Nik-Sch/EDiC/thesis/eidesstatt.tex

% !TeX root = thesis.tex
\thispagestyle{empty}
\begin{LARGE}
	\ul{\textbf{Eidesstattliche Erkl\"arung}}
\end{LARGE}

\vspace{1cm}

Hiermit erkläre ich, dass ich die vorliegende Arbeit selbstständig und eigenhändig sowie ohne
unerlaubte fremde Hilfe und ausschlie\ss lich unter Verwendung der aufgeführten Quellen und Hilfsmittel
angefertigt habe.
\vspace{2cm}

Berlin, den \today

\vspace{1cm}

\rule{0.3\textwidth}{0.4pt}

Unterschrift

%\Datum
\vspace*{6cm}
\newpage
