Nik-Sch/EDiC/thesis/titlepage.tex

% !TeX root = ../thesis.tex
\begin{titlepage}
\begin{centering}
	% Header
	\begin{figure}[!h]
		\centering
		\begin{subfigure}{.45\textwidth}
			% \centering
			
		\end{subfigure}
		\begin{subfigure}{.45\textwidth}
			\centering
			
		\end{subfigure}
	\end{figure}

	% vertikaler Zwischenraum
	\vspace{10mm}

	% Titel der Arbeit
	\LARGE

	Master Thesis

	\textbf{\Title}\\[1cm]

	\large
	created by\\
	\Author\\
	Matrikel: 376314\\[1cm]

	% Betreuer
	\hspace*{-1.5cm}
	\begin{minipage}{\linewidth}
		\begin{tabbing}
    	First examiner:\qquad \= Prof. Dr.-Ing. Reinhold Orglmeister,\\
			\>{Chair of Electronics and Medical Signal Processing,}\\
			\>{Technische Universität Berlin}\\
			\\
    	Second examiner:\>Prof. Dr.-Ing. Clemens Gühmann,\\
			\>{Chair of Electronic Measurement and Diagnostic Technology,}\\
			\>{Technische Universität Berlin}\\
			\\
    	Supervisor:\>Dipl.-Ing. Henry Westphal,\\
			\>{Tigris Elektronik GmbH}
  	\end{tabbing}
  \end{minipage}

	% vertikaler Zwischenraum
	\vspace{20mm}

	\normalsize

	\Date\\
\end{centering}
\end{titlepage}
