Nik-Sch/EDiC/thesis/plots/magneticField1.pdf

0 | 20 | 40 | 60 | 80 | 100
x in mm

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
H in Am

−1

2 wires 20mm apart
2 wires 1mm apart
