Nik-Sch/EDiC/Inbetriebnahme/2022-03-06/2022-03-06_NK.pdf

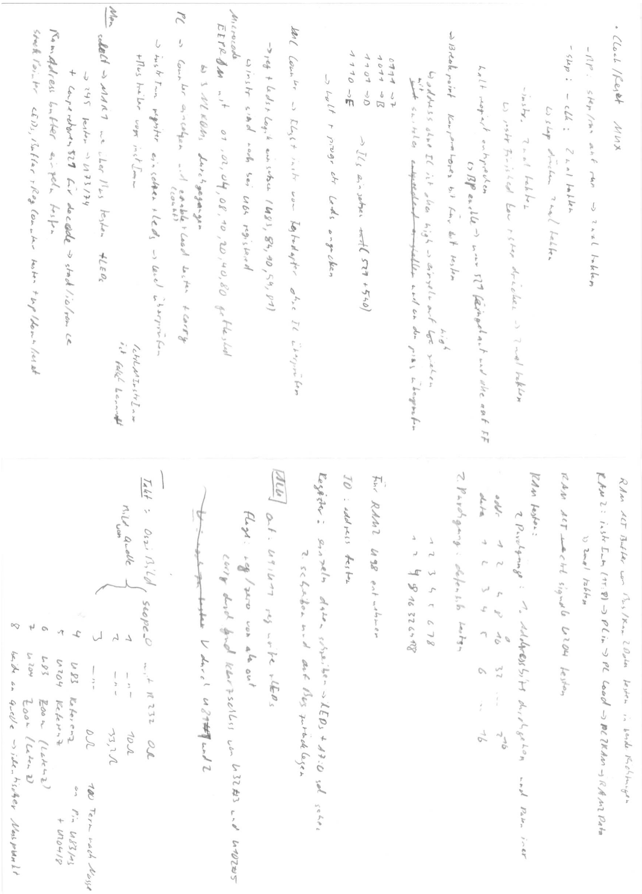
[picture p56: page 1]
