Nik-Sch/EDiC/doc/docHenry/fauch_0108202115232300.pdf

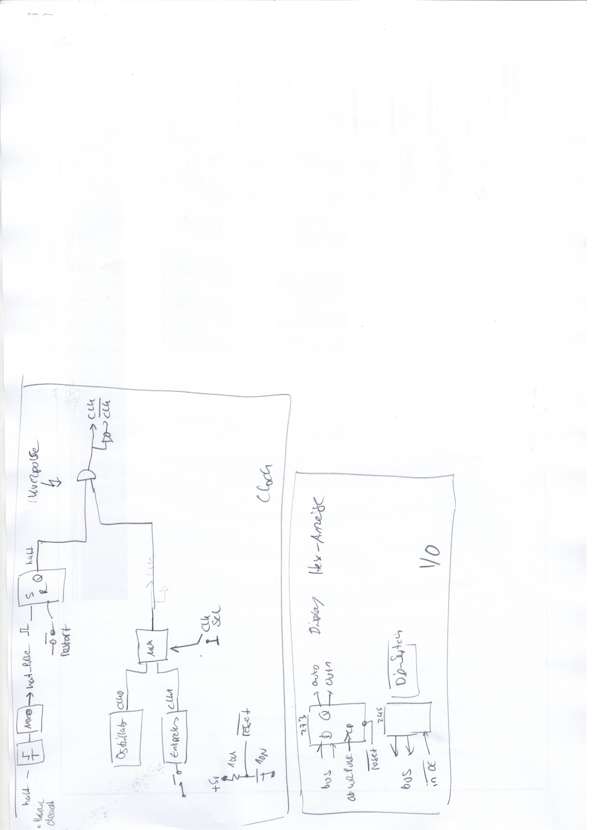
[picture p57: page 1]
