Nik-Sch/EDiC/doc/docHenry/fauch_0108202115245300.pdf

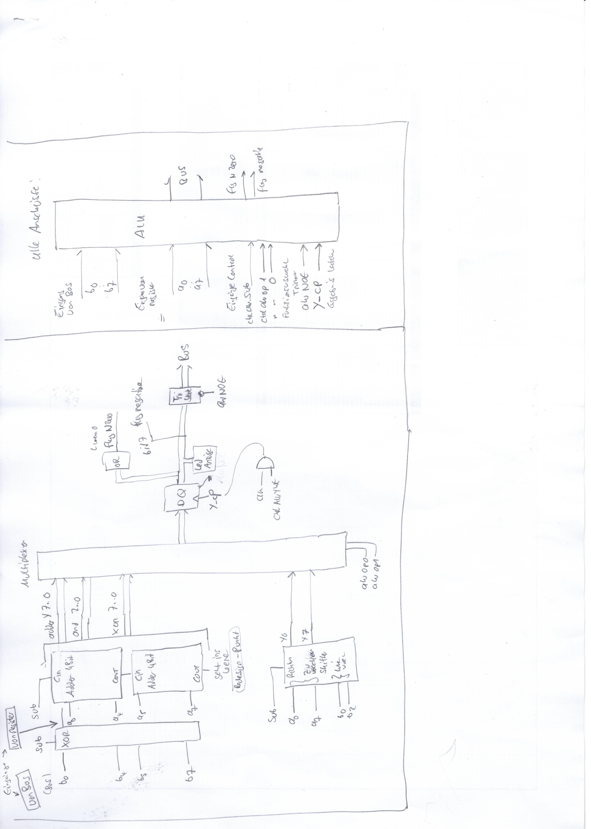
[picture p58: page 1]
