Nik-Sch/EDiC/doc/docHenry/fauch_0108202115251600.pdf

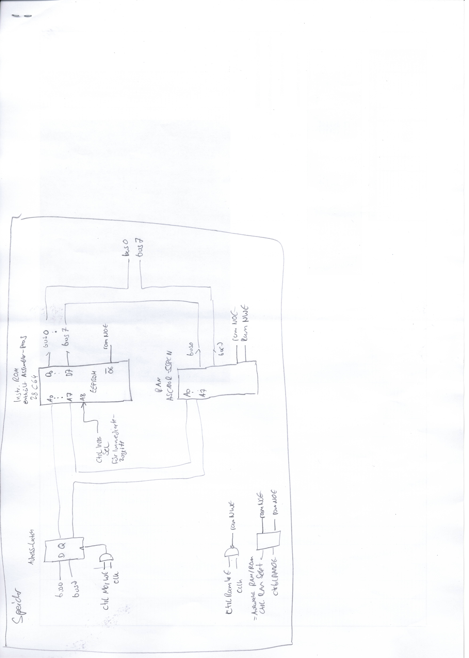
[picture p59: page 1]
