Nik-Sch/EDiC/doc/docHenry/fauch_0108202115253700.pdf

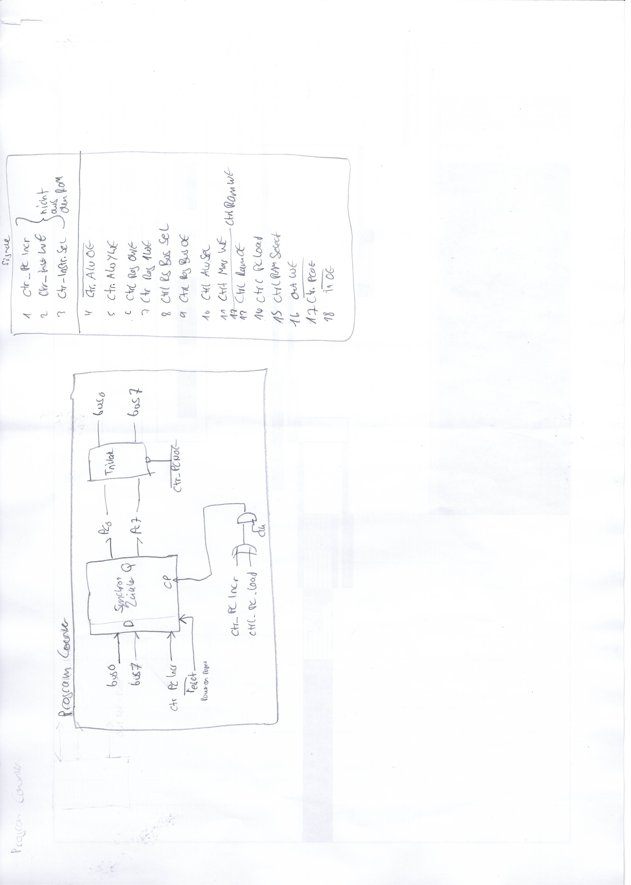
[picture p60: page 1]
