Nik-Sch/EDiC/doc/docHenry/fauch_0108202115255800.pdf

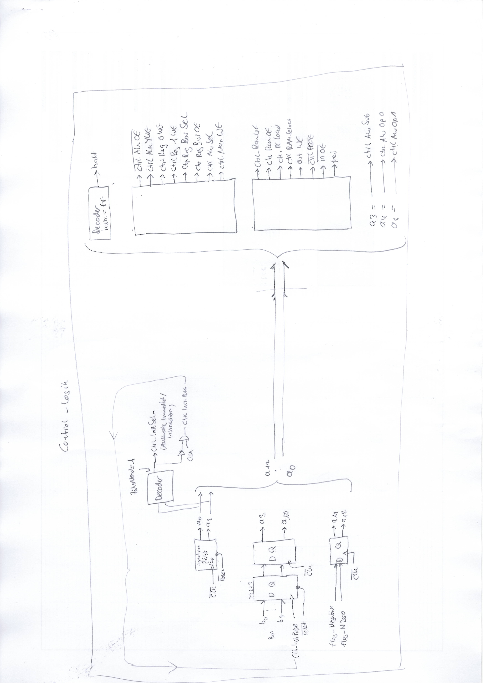
[picture p61: page 1]
