Nik-Sch/EDiC/doc/docHenry/fauch_0108202115262200.pdf

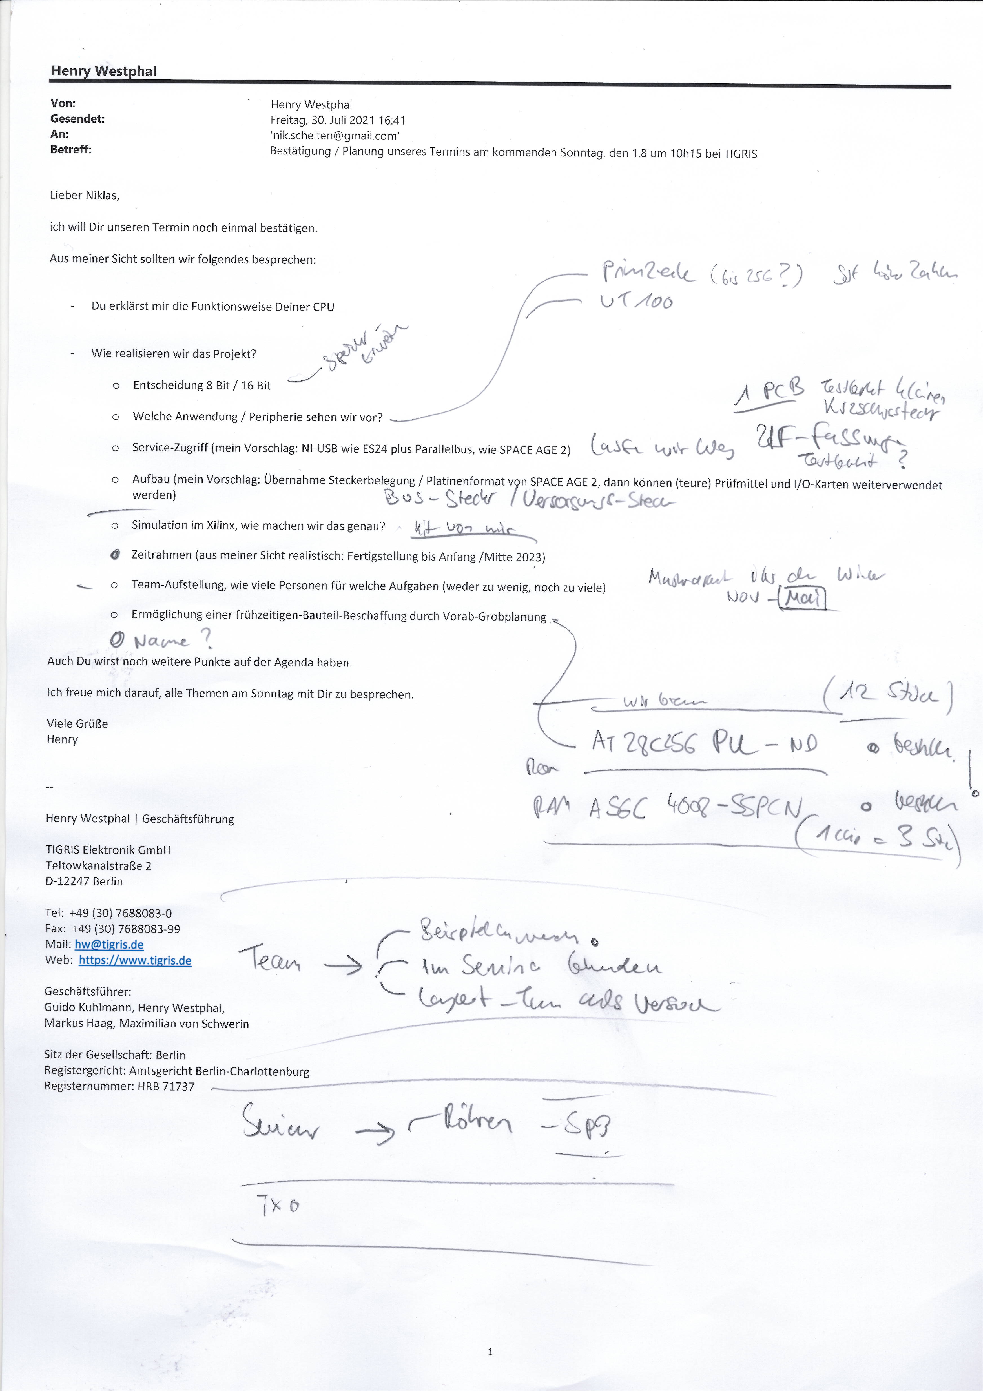
[picture p62: page 1]
