Nik-Sch/EDiC/doc/docHenry/fauch_0108202115264400.pdf

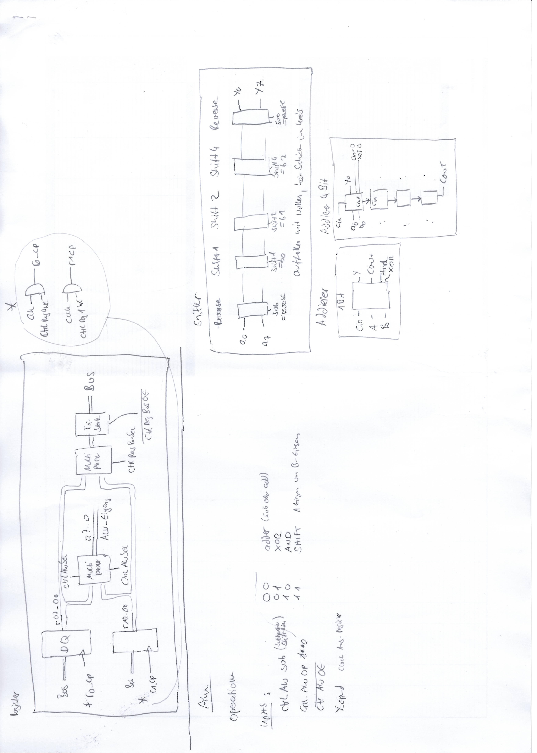
[picture p63: page 1]
