Nik-Sch/EDiC/doc/docHenry/fauch_0108202115271000.pdf

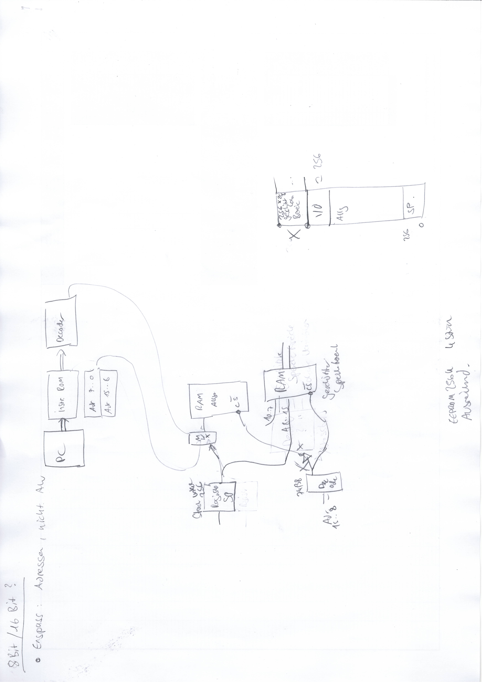
[picture p64: page 1]
