Nik-Sch/EDiC/Inbetriebnahme/2022-03-07/RigolDS0.png

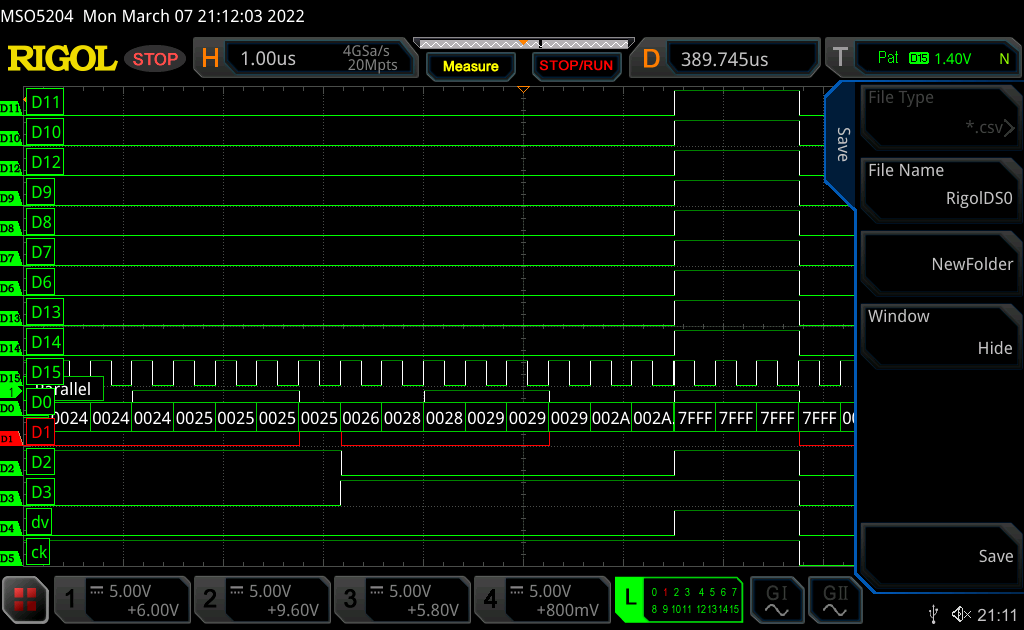
Inbetriebnahme/2022-03-07/RigolDS0.png
