Nik-Sch/EDiC/schematic/emsp_resized.png

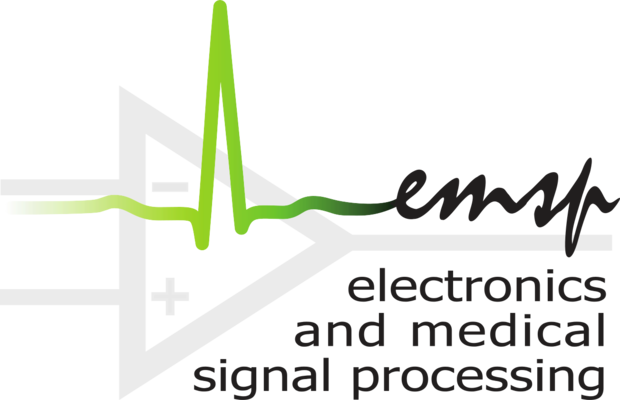
schematic/emsp_resized.png
