Nik-Sch/EDiC/schematic/tigris.png

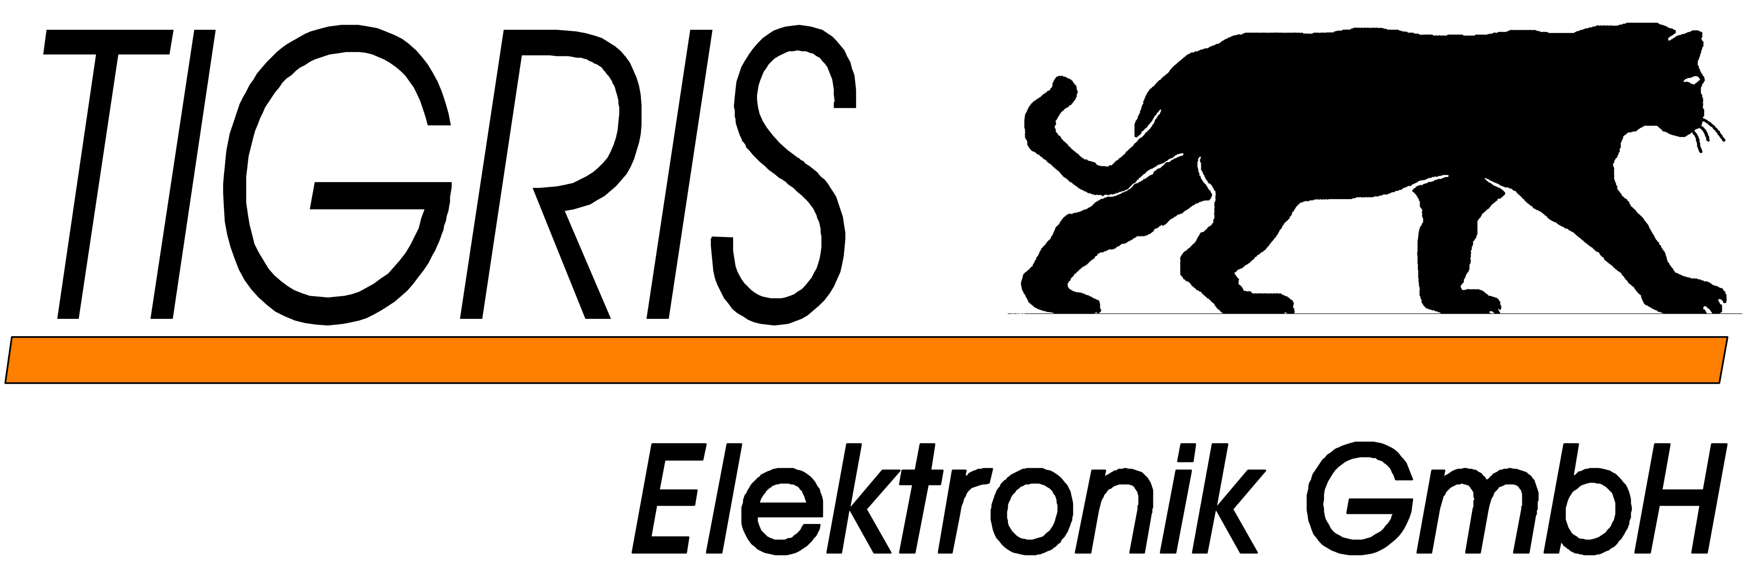
schematic/tigris.png
