Nik-Sch/EDiC/schematic/tu_resized.png

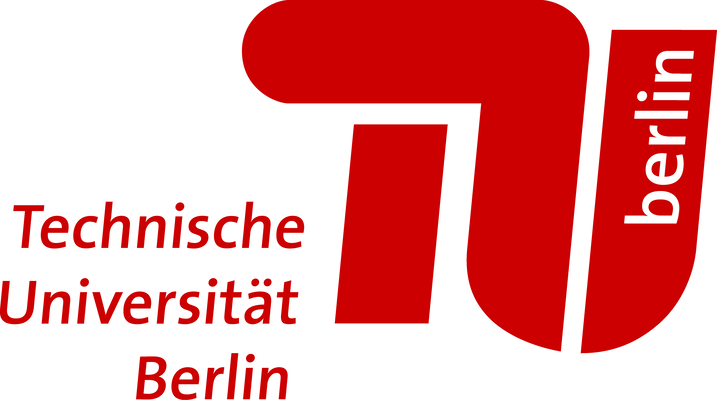
schematic/tu_resized.png
