Nik-Sch/EDiC/thesis/figures/scope_1.png

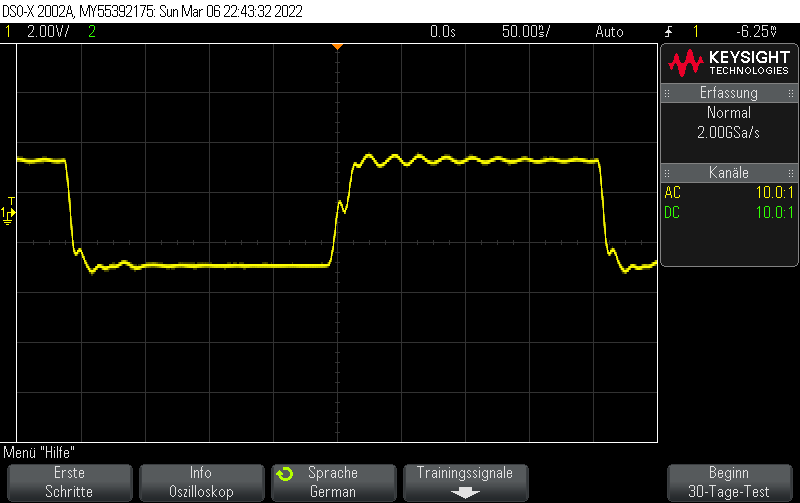
thesis/figures/scope_1.png
