Nik-Sch/EDiC/thesis/figures/scope_4.png

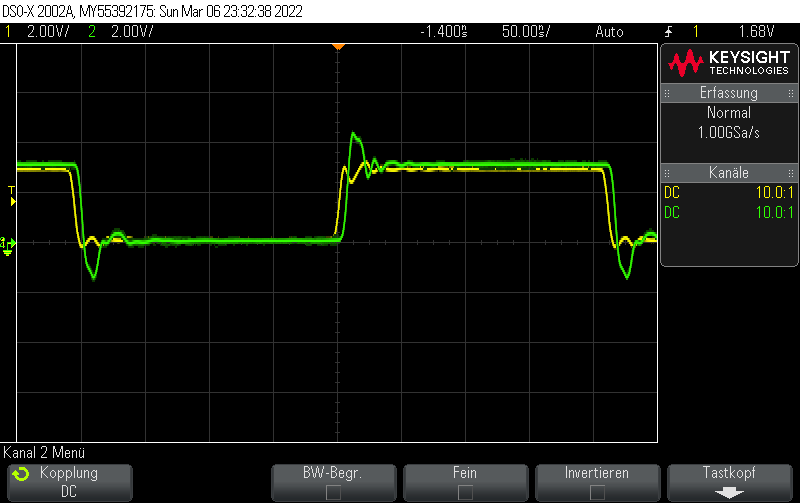
thesis/figures/scope_4.png
