Nik-Sch/EDiC/thesis/figures/scope_6.png

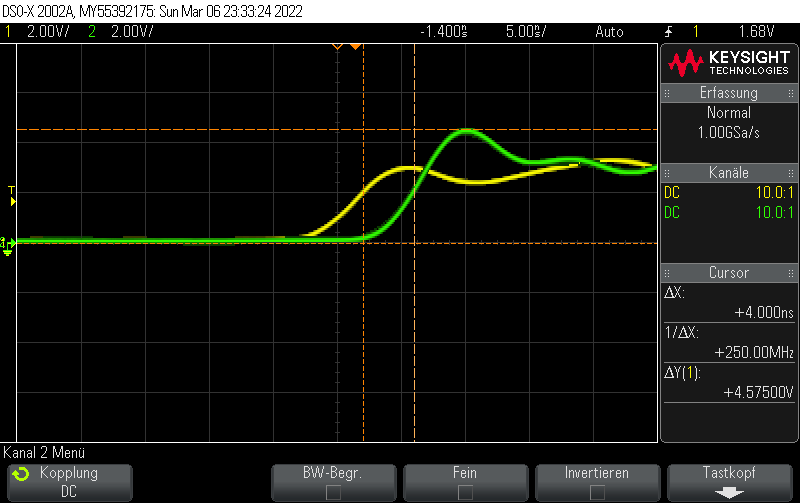
thesis/figures/scope_6.png
