Nik-Sch/EDiC/thesis/figures/scope_8.png

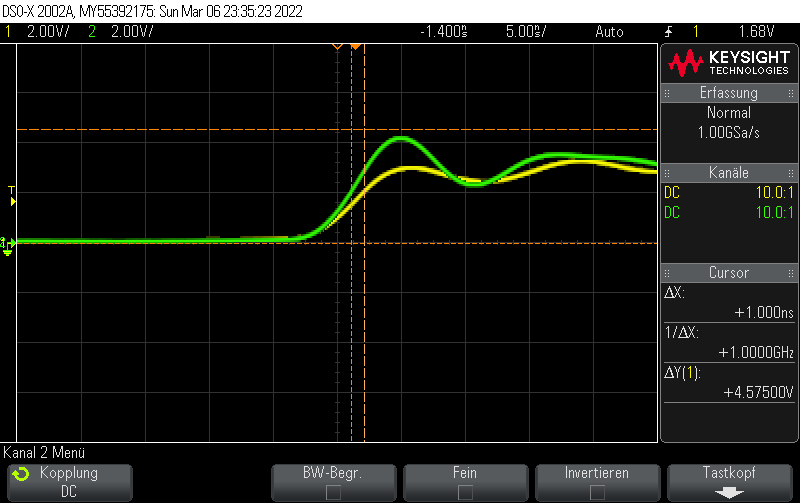
thesis/figures/scope_8.png
