Nik-Sch/EDiC/thesis/figures/scope_11.png

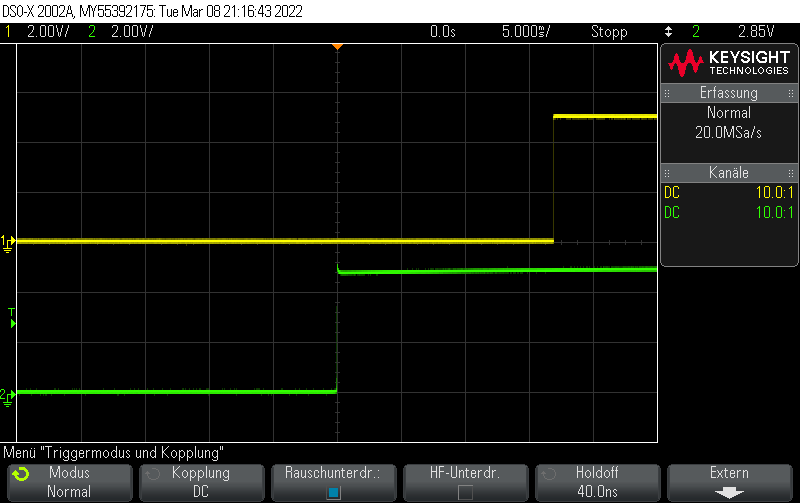
thesis/figures/scope_11.png
