Nik-Sch/EDiC/thesis/figures/scope_13.png

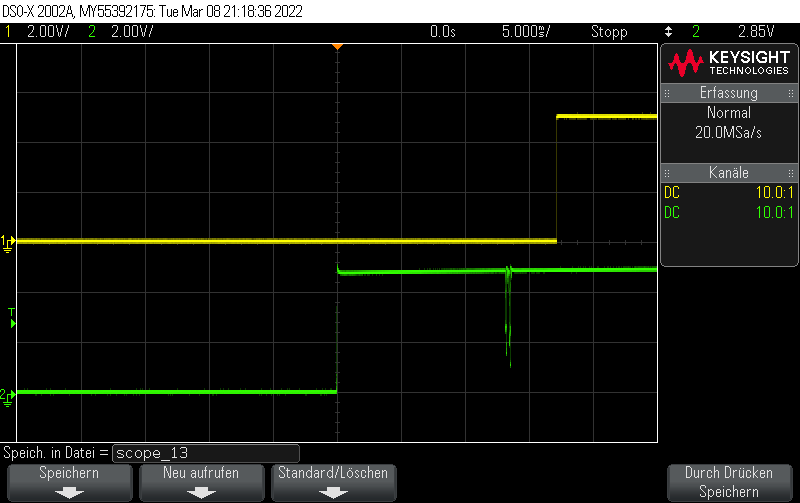
thesis/figures/scope_13.png
