Nik-Sch/EDiC/thesis/figures/scope_14.png

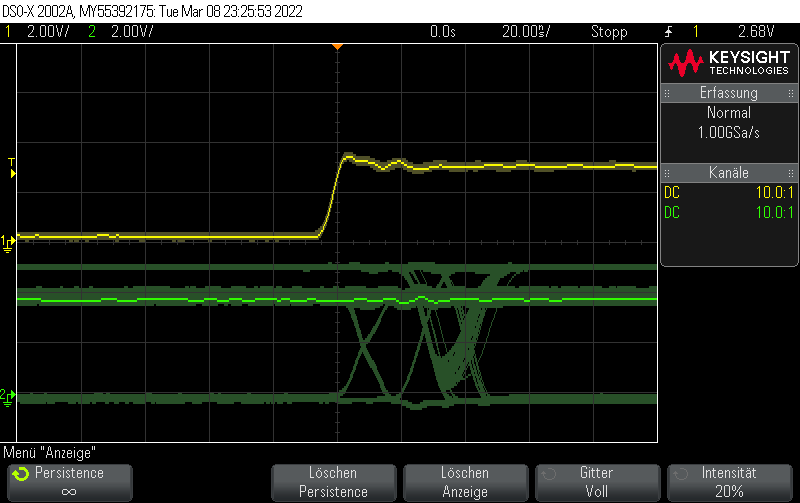
thesis/figures/scope_14.png
