Nik-Sch/EDiC/thesis/figures/scope_16.png

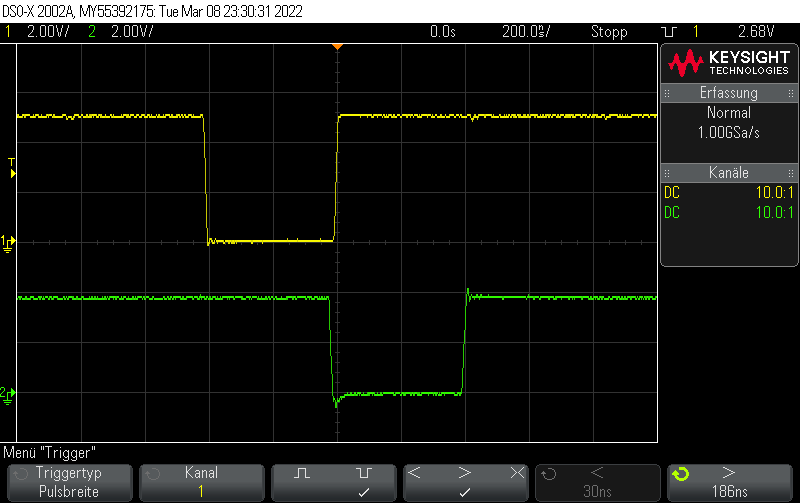
thesis/figures/scope_16.png
