Nik-Sch/EDiC/thesis/figures/update20210121_crop.jpg

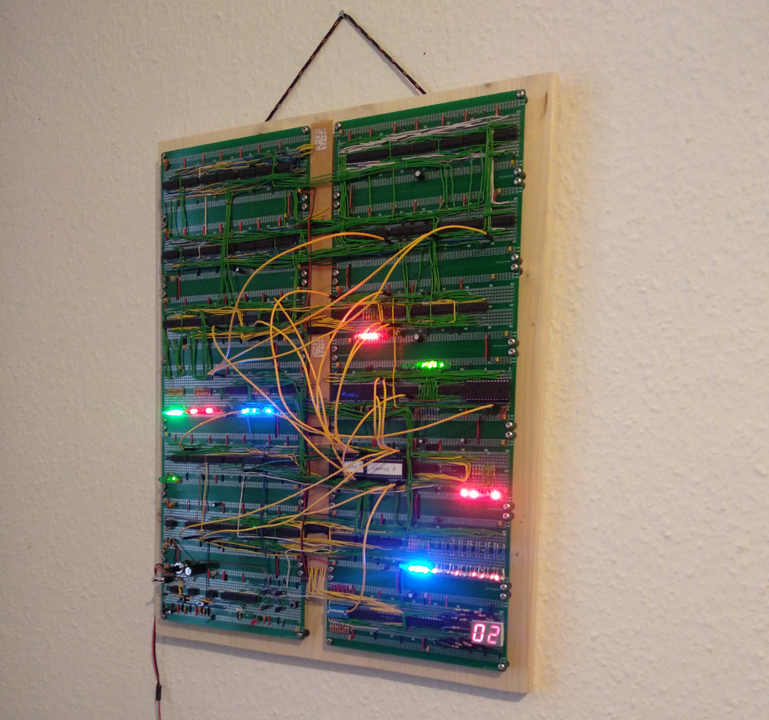
thesis/figures/update20210121_crop.jpg
