Nik-Sch/EDiC/thesis/appendix/c_assembler.tex

\chapter[Collection of assembler programs]{Collection of assembler programs for the \gls{EDiC}}
\begin{multipagecode}
  \caption{The full snake assembler program.}
  \begin{multicols}{2}
    \inputminted[linenos,
      breaklines,
      frame=leftline,
      xleftmargin=20pt,
    ]{ARM}{src/snake.s}
  \end{multicols}
  \label{lst:app_asm_snake}
\end{multipagecode}

\begin{multipagecode}
  \caption{The \gls{PRNG} assembler program ``prng.s'' used in the snake program in \cref{lst:app_asm_snake}.}
  \inputminted[linenos,
    breaklines,
    frame=leftline,
    xleftmargin=20pt,
  ]{ARM}{src/prng.s}
  \label{lst:app_asm_prng}
\end{multipagecode}

\begin{multipagecode}
  \caption{The utility library for the \gls{UART} extension card of the \gls{EDiC} with the \texttt{16c550} \gls{UART} Transceiver.}
  \begin{multicols}{2}
    \inputminted[linenos,
      breaklines,
      frame=leftline,
      xleftmargin=20pt,
    ]{ARM}{src/uart_16c550.s}
  \end{multicols}
  \label{lst:app_asm_uart}
\end{multipagecode}
