Nik-Sch/EDiC/thesis/figures/ledDriver.pdf

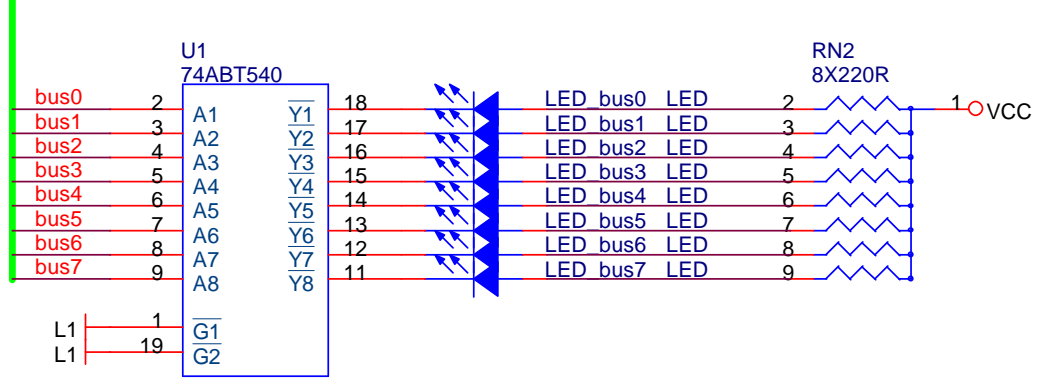
[picture p87: page 1]
bus3; bus6; bus1; bus7; bus0; bus4 bus5; bus2; VCC; LED_bus2 LED; LED_bus0 LED; LED_bus4 LED; U1 74ABT540; LED_bus5 LED; LED_bus7 LED; LED_bus6 LED; LED_bus3 LED; LED_bus1 LED
