Nik-Sch/EDiC/thesis/figures/schematic_5.pdf

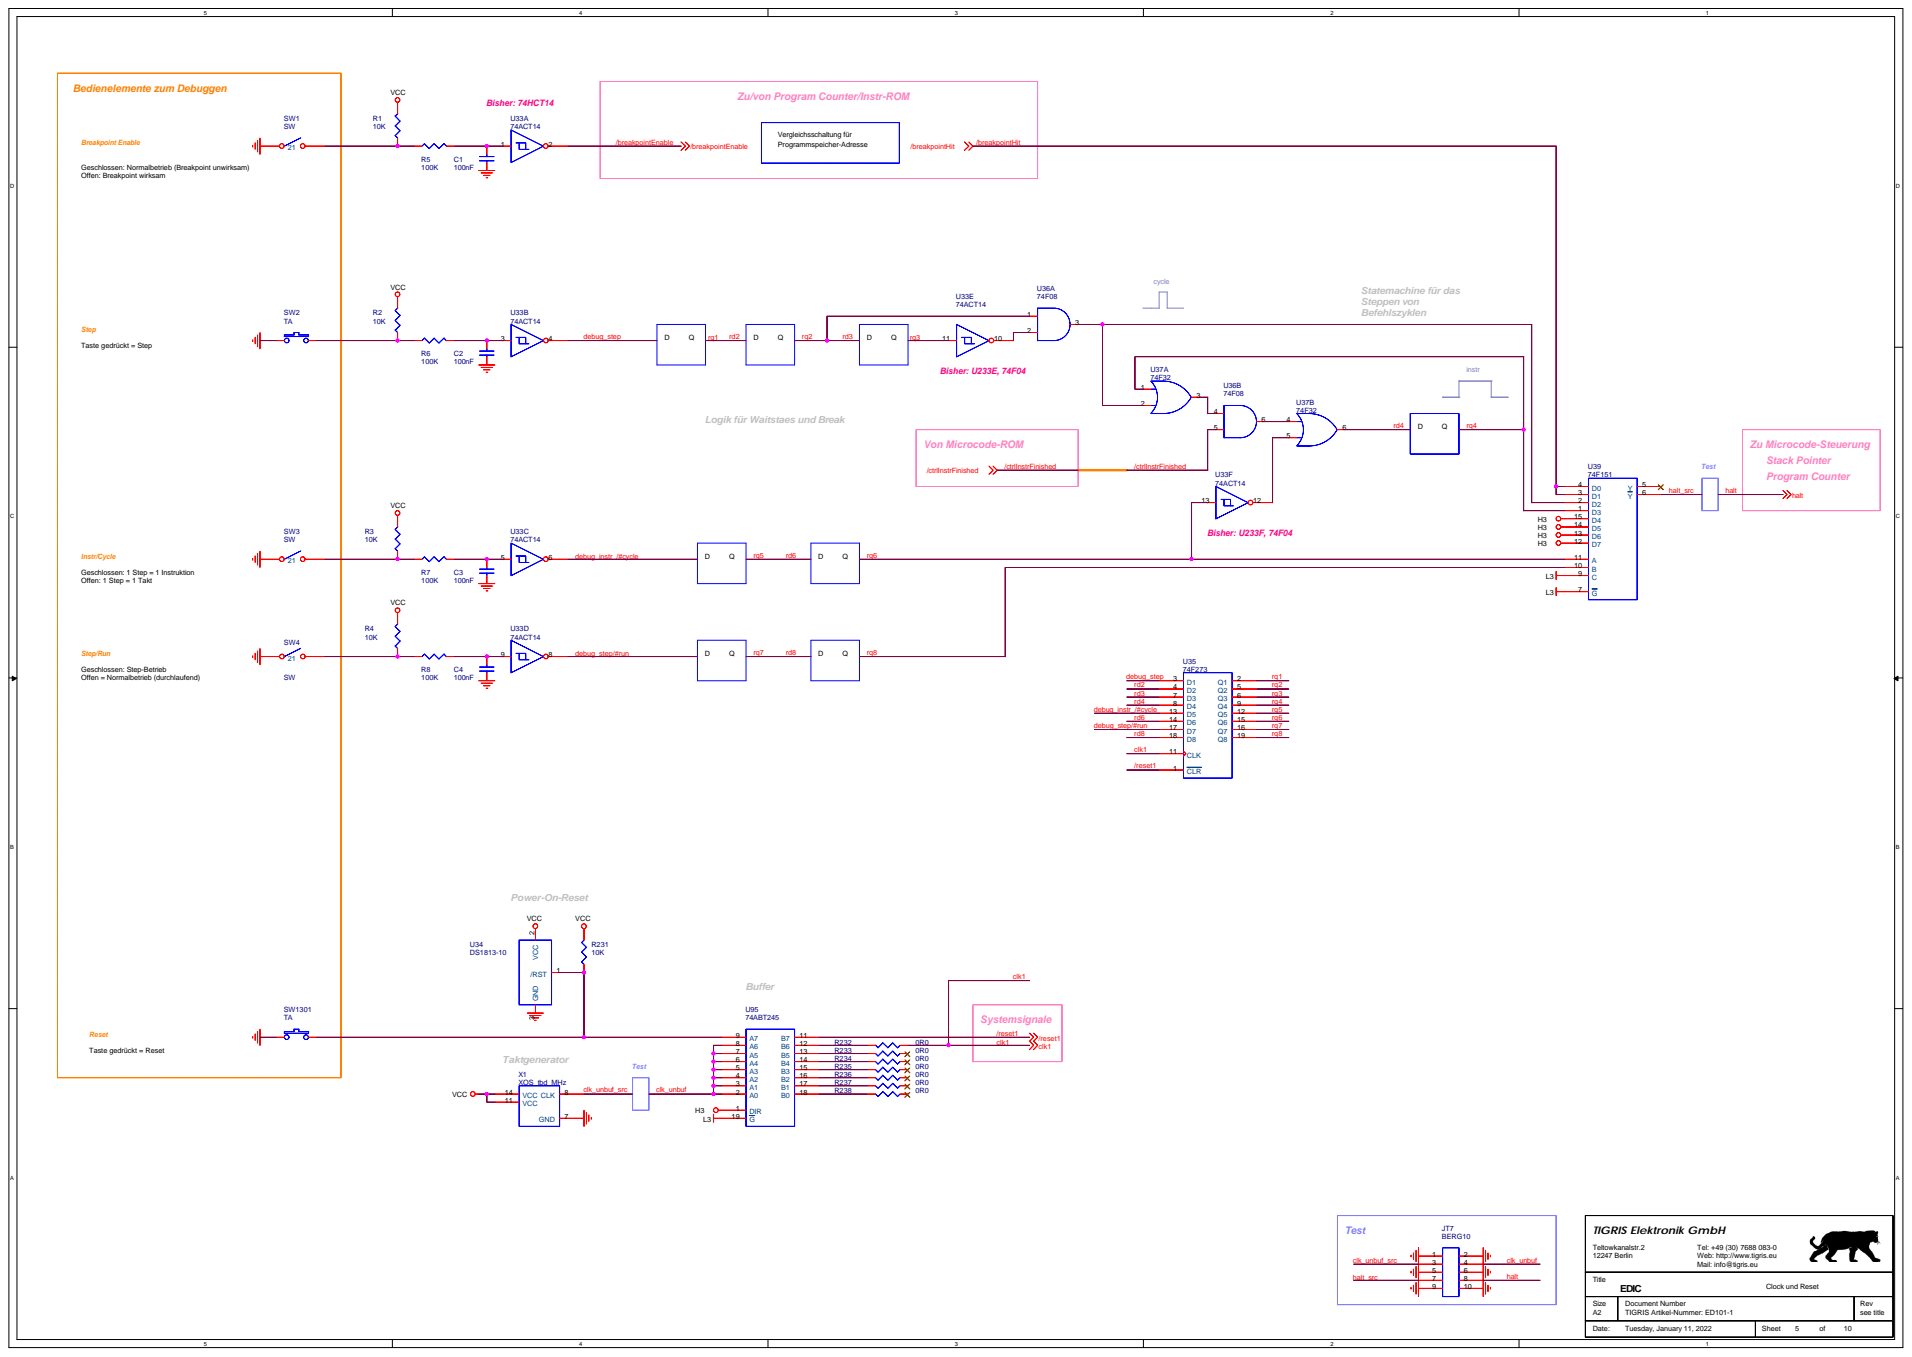
[picture p88: page 1]

Zu/von Program Counter/Instr-ROM

Geschlossen: Normalbetrieb (Breakpoint unwirksam)
Offen: Breakpoint wirksam

Logik für Waitstaes und Break

Tel: +49 (30) 7688 083-0
Web: http://www.tigris.eu
Mail: info@tigris.eu

Size A2 | Document Number TIGRIS Artikel-Nummer: ED101-1 | Rev see title

Date: Tuesday, January 11, 2022 | Sheet 5 of 10
