Nik-Sch/EDiC/schematic/CPU-Poster/EDiCPoster.pdf

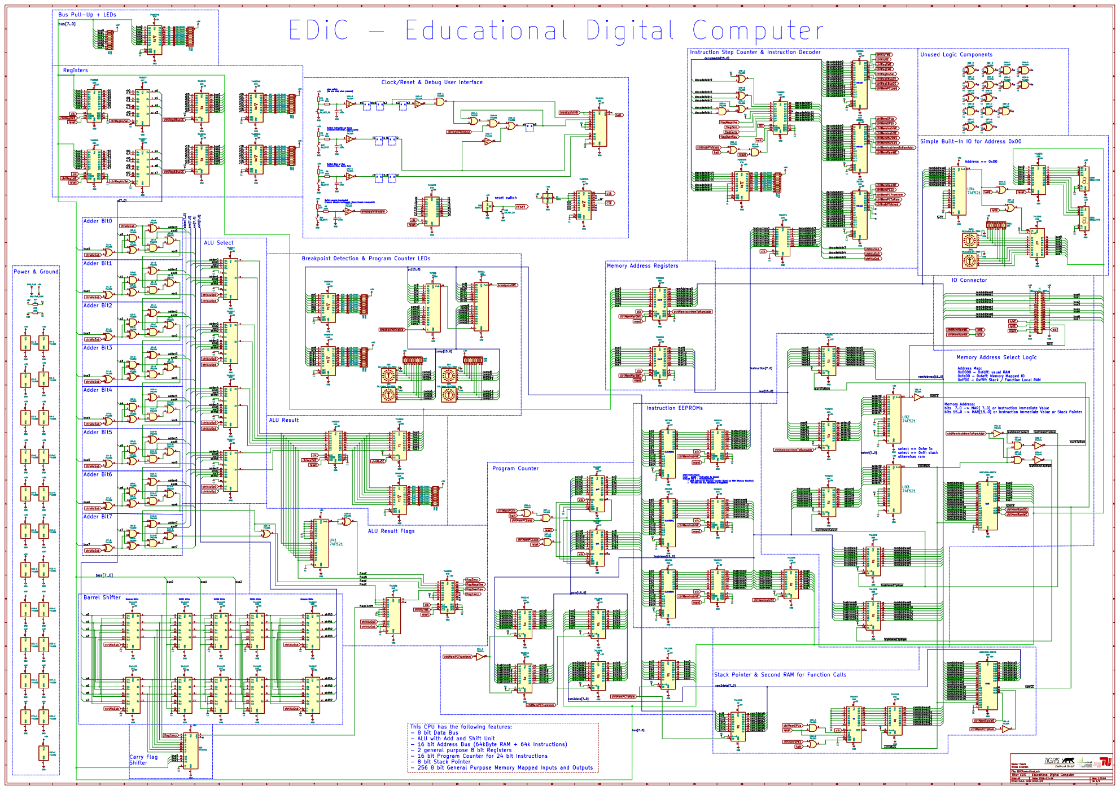
[picture p89: page 1]

Bus Pull-Up + LEDs

Instruction Step Counter & Instruction Decoder

Clock/Reset & Debug User Interface

micro0 Breakpoint Detection & Program Counter LEDs

step switch
(do one step when pressed)
74LS14 GND

Switch Instruction or Cycle
(Closed: Instruction, Open: Cycle)

Simple Built-In IO for Address 0x00

Switch Step or Run
(Closed: Step, Open: Run)

Switch enable breakpoint
(Closed: Disable breakpoint, Open: Enable breakpoint)

Memory Address Select Logic

0xff00 - 0xffff: Stack / Function Local RAM

Memory Address:
bits 7..0 -> MAR[ 7..0] or Instruction Immediate Value
bits 15..0 -> MAR[15..0] or Instruction Immediate Value or Stack Pointer

rom1&0 15: 0 - immediateValue:
- 15:0 address for Program Counter (jump) or RAM (Memory Oeration)
- 7:0 data for ALU Operation or Registers

This CPU has the following features:
- 8 bit Data Bus
- ALU with Add and Shift Unit
- 16 bit Address Bus (64kByte RAM + 64k Instructions)
- 2 general purpose 8 bit Registers
- 16 bit Program Counter for 24 bit Instructions
- 8 bit Stack Pointer
- 256 8 bit General Purpose Memory Mapped Inputs and Outputs

File: EDiCPoster.kicad_sch Niklas Schelten Master Thesis

Id: 1/1 Title: EDiC - Educational Digital Computer
