Nik-Sch/EDiC/thesis/figures/schemTA.pdf

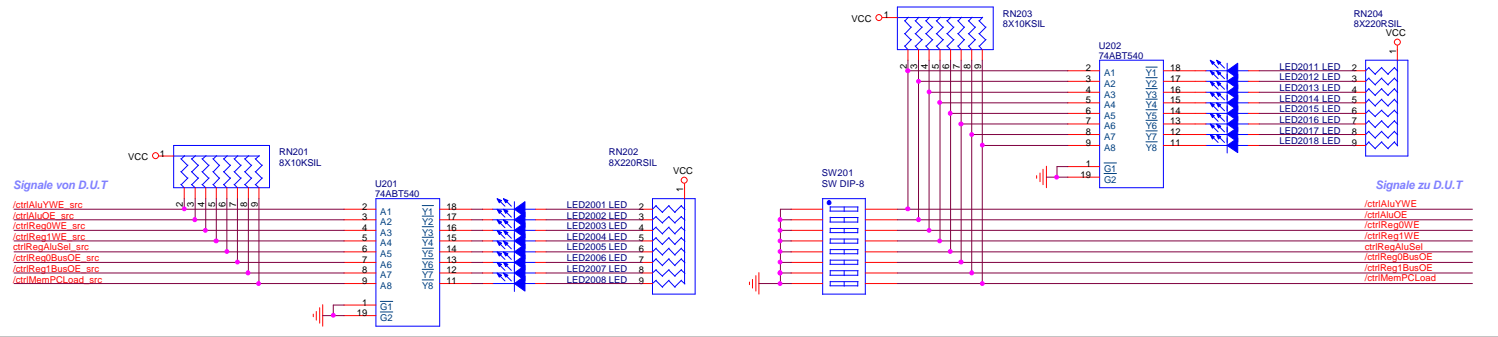
[picture p90: page 1]
