Nik-Sch/EDiC/thesis/figures/schemBasicIO.pdf

## Von Schaltungsteil RAM

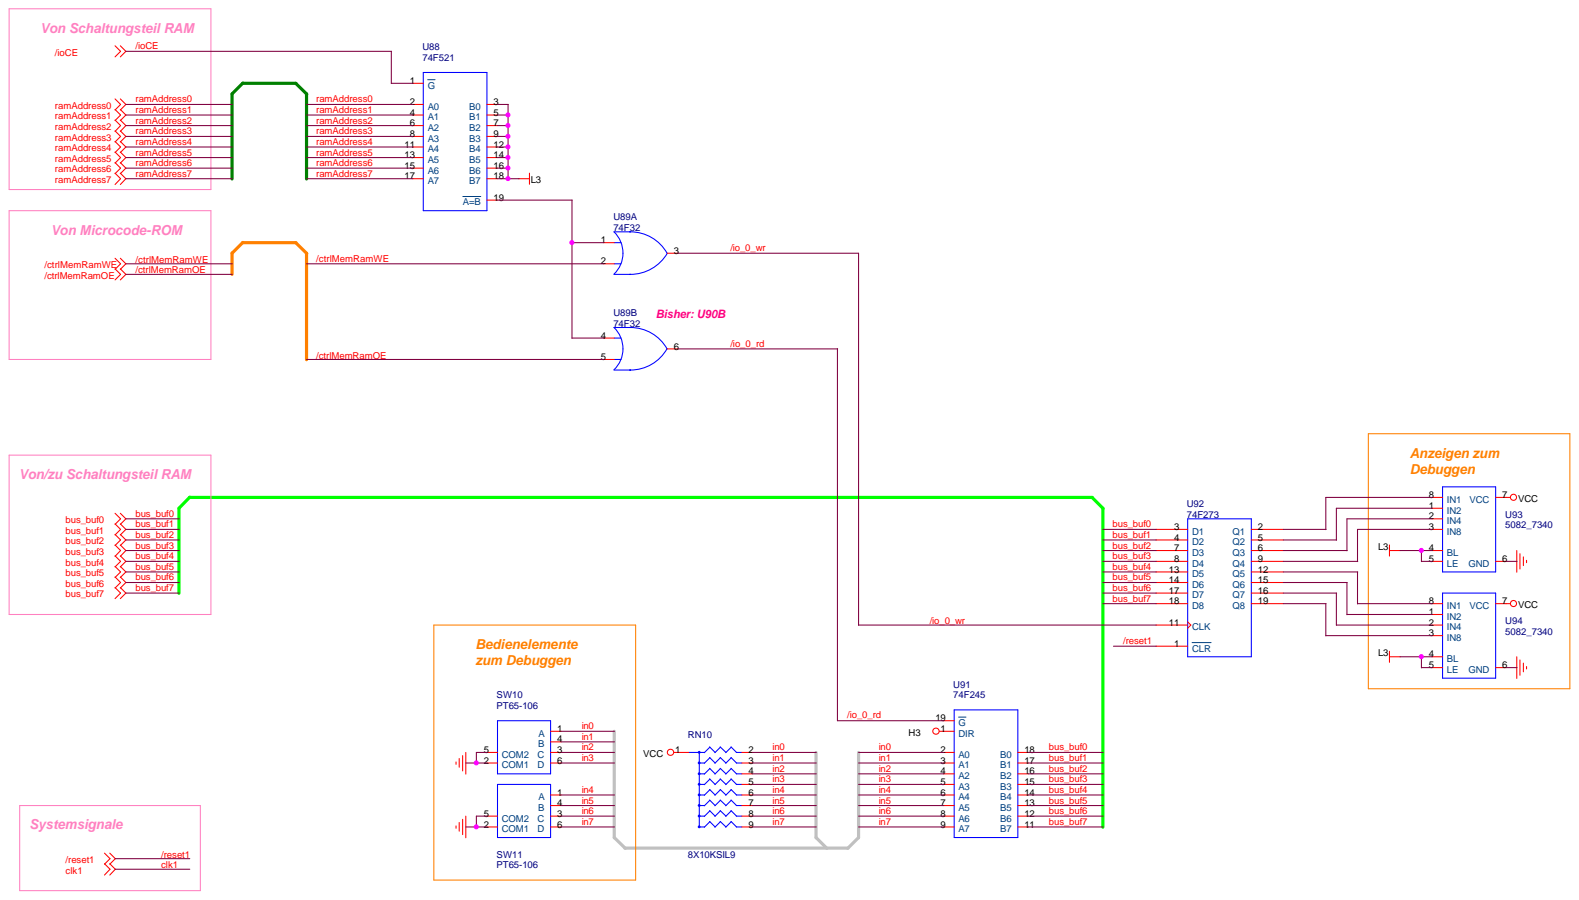
[picture p91: page 1]

ramAddress1 4 | 5
ramAddress2 6 | 7
ramAddress3 8 | 9
ramAddress4 11 | 12
ramAddress5 13 | 14
ramAddress6 15 | 16
ramAddress7 17 | 18

Von/zu Schaltungsteil RAM

1 | IN1 VCC U92

bus_buf1 4 | 5
bus_buf2 7 | 6
bus_buf3 8 | 9
bus_buf4 13 | 12
bus_buf5 14 | 15
bus_buf6 17 | 16

in2 4 | bus_buf2 16
in3 5 | 15 bus_buf3
