Nik-Sch/EDiC/thesis/figures/schemPC.pdf

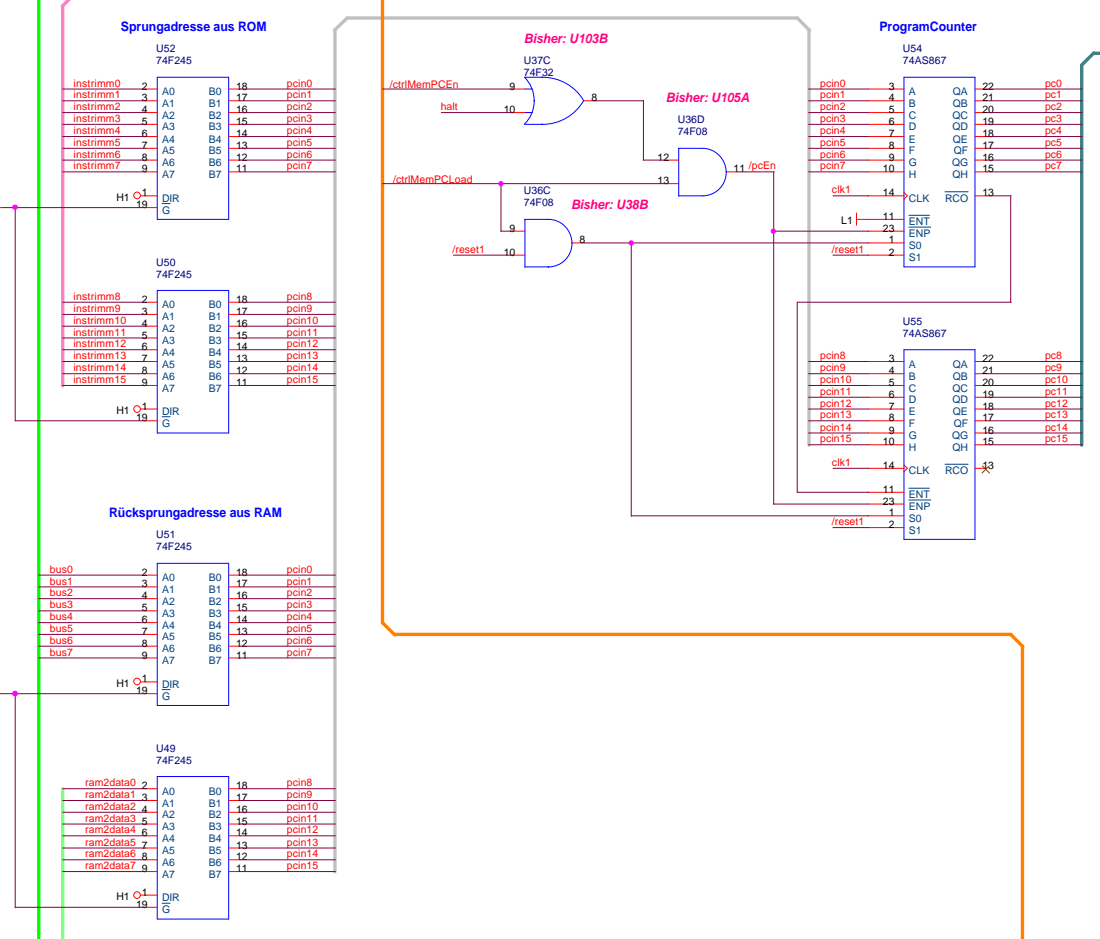
[picture p92: page 1]
