Nik-Sch/EDiC/thesis/figures/7400_Circuit.pdf

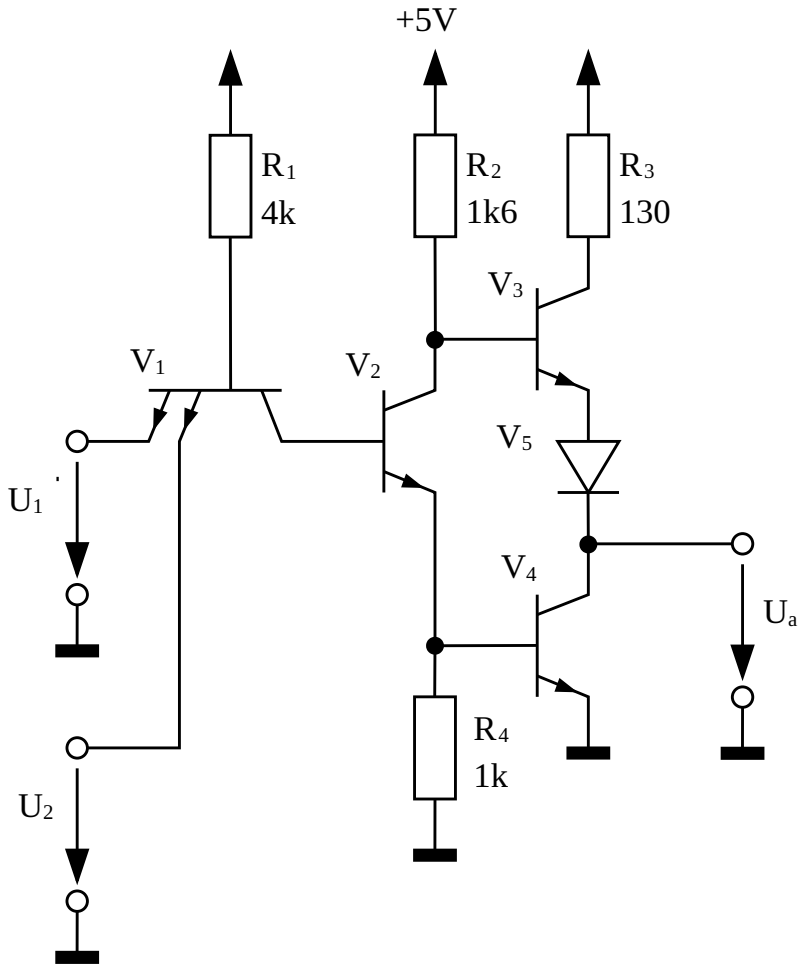
[picture p93: page 1]
