Nik-Sch/EDiC/thesis/figures/schematic_2.pdf

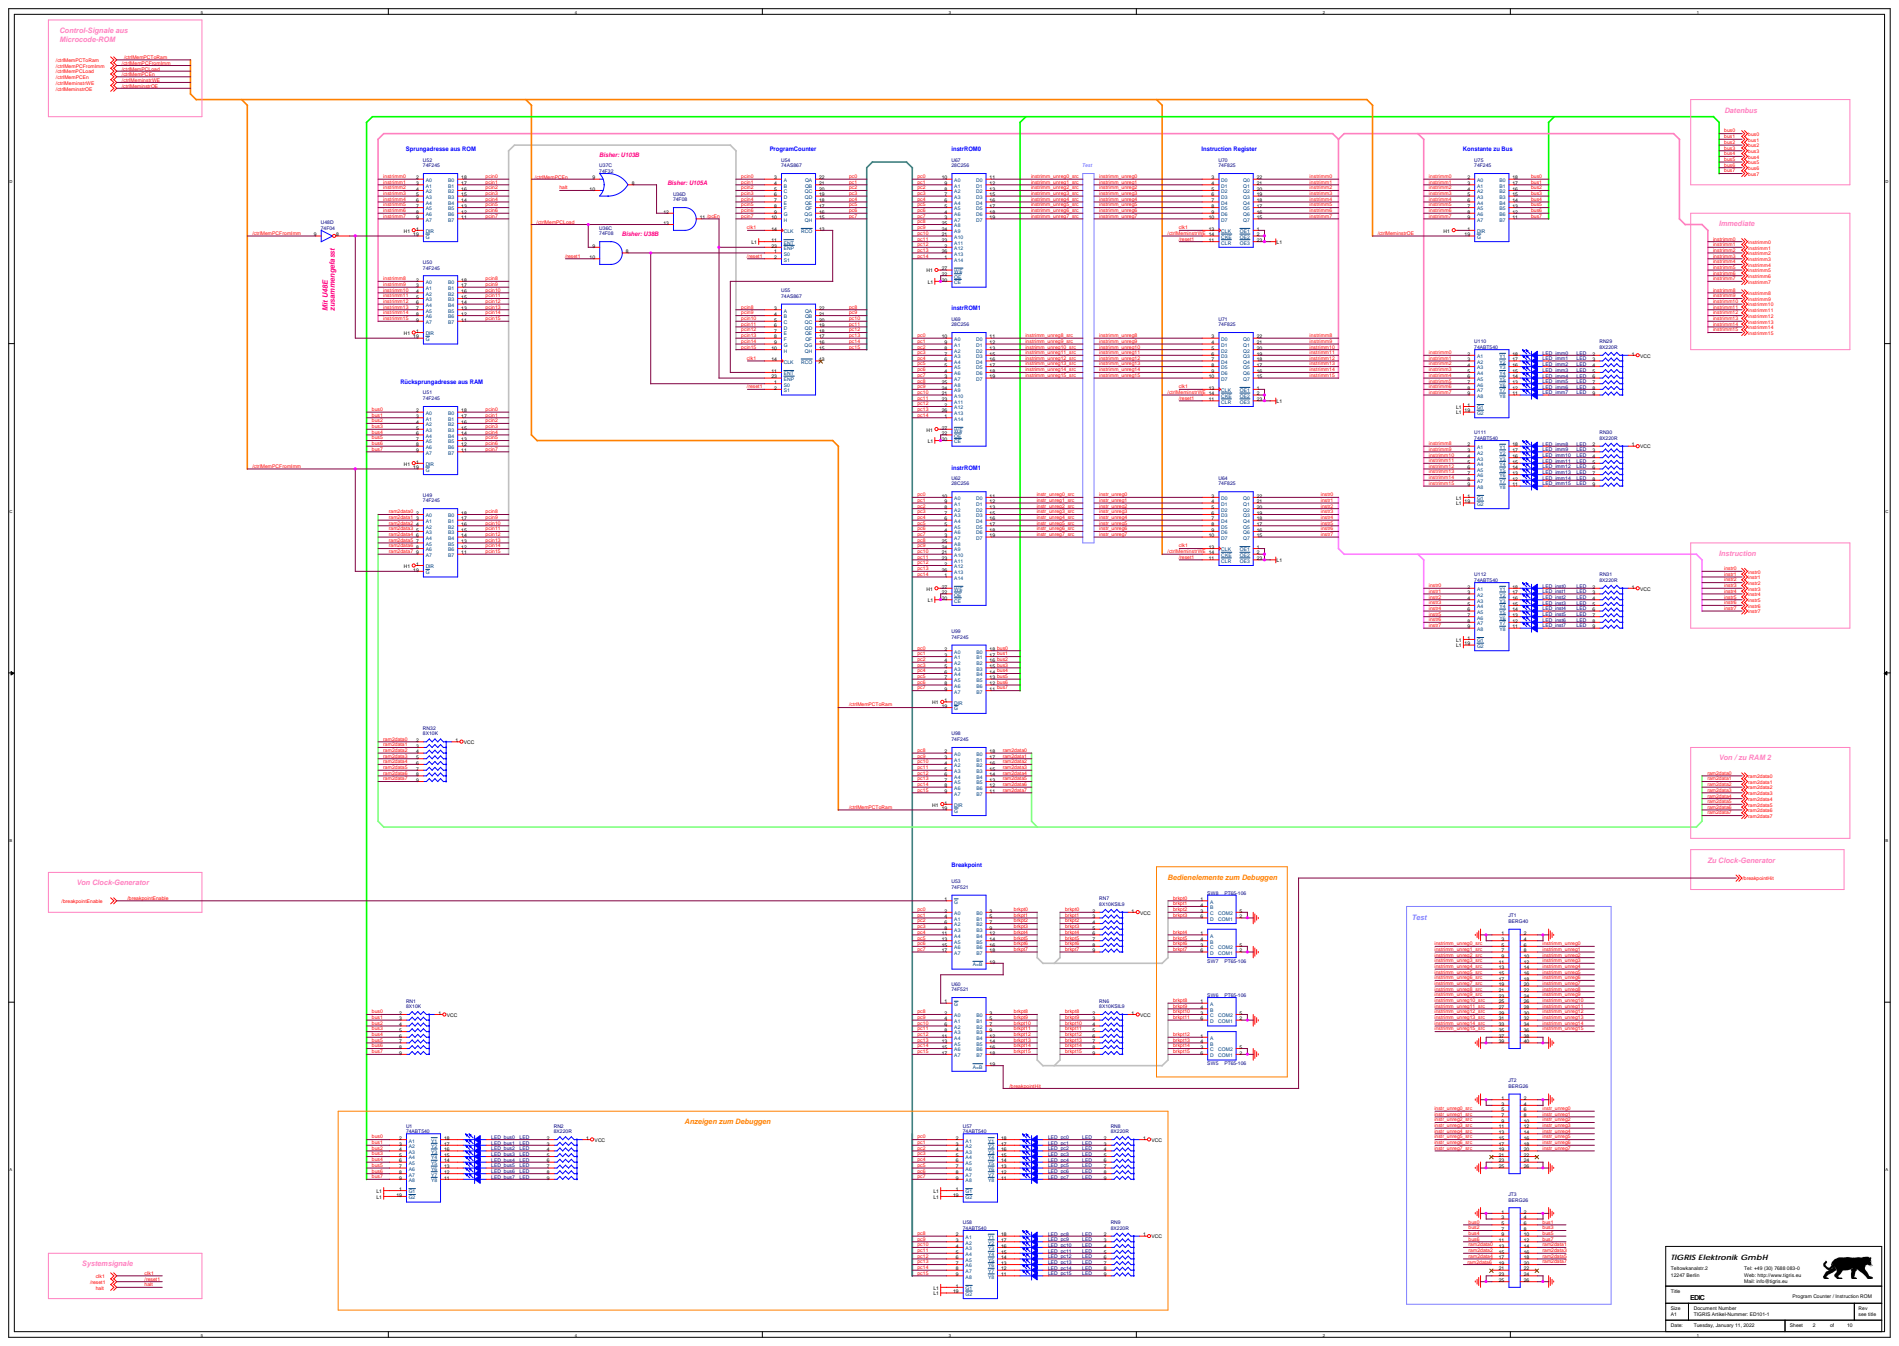
[picture p94: page 1]

instr_unreg0 | clk1 /ctrlMeminstrWE 13 14 | instrimm5

instr_unreg2 | 3456789 | 20 instr2
instr_unreg1 | | 21 instr1

Tel: +49 (30) 7688 083-0
Web: http://www.tigris.eu
Mail: info@tigris.eu

Program Counter / Instruction ROM

Size A1 | Document Number TIGRIS Artikel-Nummer: ED101-1 | Rev see title

Date: Tuesday, January 11, 2022 | Sheet 2 of 10
