Nik-Sch/EDiC/thesis/figures/schematic_3.pdf

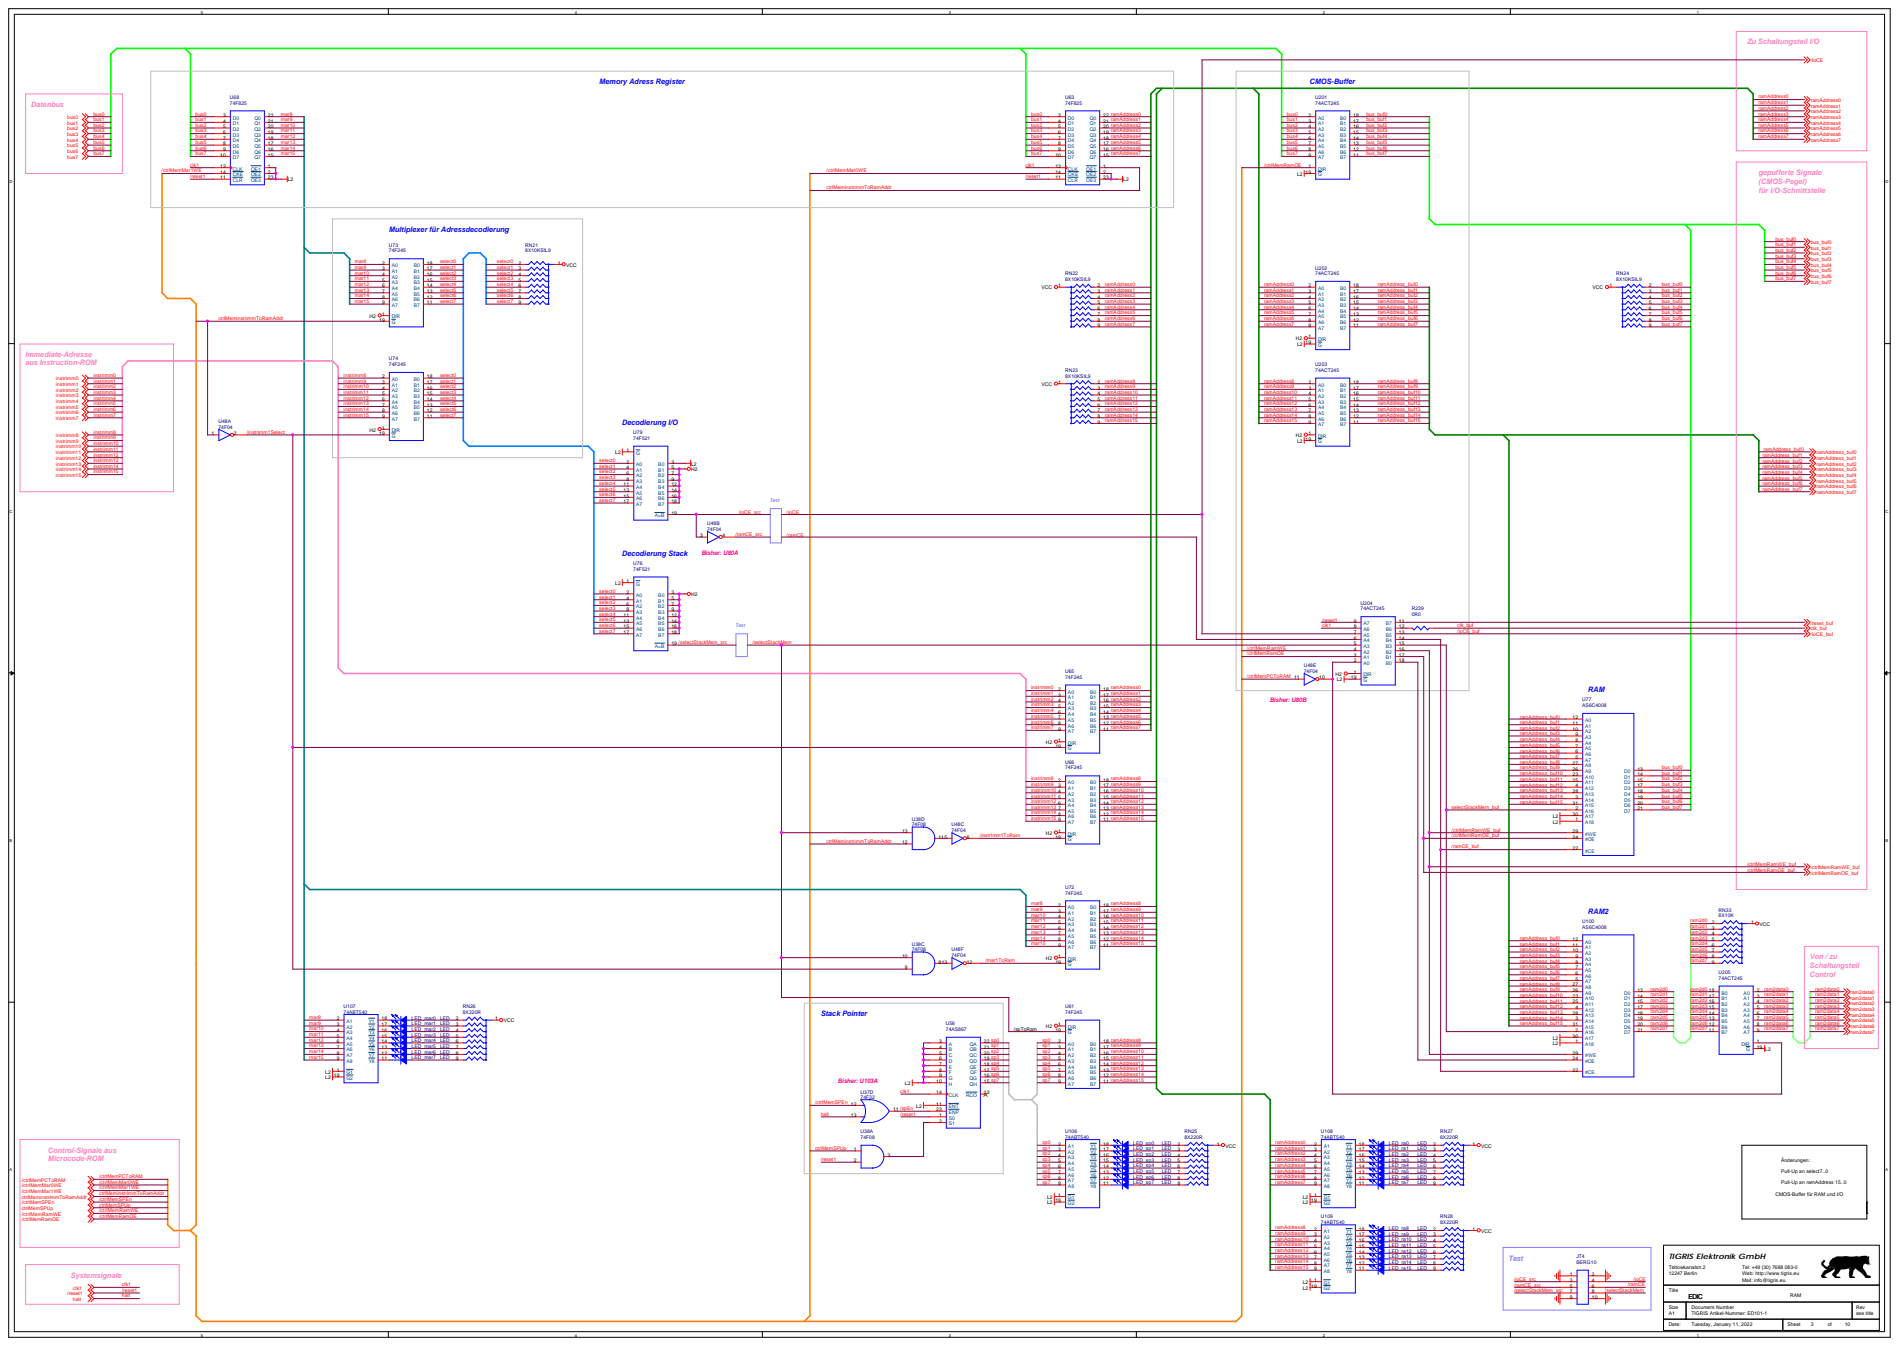
[picture p95: page 1]

U65 74F245 | /ctrlMemRamWE 4

ramAddress_buf10 23 | | 14 bus_buf1

ramAddress_buf12 4 | | bus_buf3 17
ramAddress_buf13 28 | | bus_buf4 18
ramAddress_buf14 3 | | 19 bus_buf5
ramAddress_buf15 31 | | 20 bus_buf6

2 | | 21 bus_buf7

/ctrlMemRamWE_buf | 30 L2 1 L2 29

/ctrlMemRamOE_buf | 24

/ramCE_buf

/ctrlMemRamOE_buf

RAM2 RN33 8X10K U100

Pull-Up an ramAddress 15..0

CMOS-Buffer für RAM und I/O

Tel: +49 (30) 7688 083-0
Web: http://www.tigris.eu
Mail: info@tigris.eu

Size A1 | Document Number TIGRIS Artikel-Nummer: ED101-1 | Rev see title

Date: Tuesday, January 11, 2022 | Sheet 3 of 10
