Nik-Sch/EDiC/thesis/figures/schematic_4.pdf

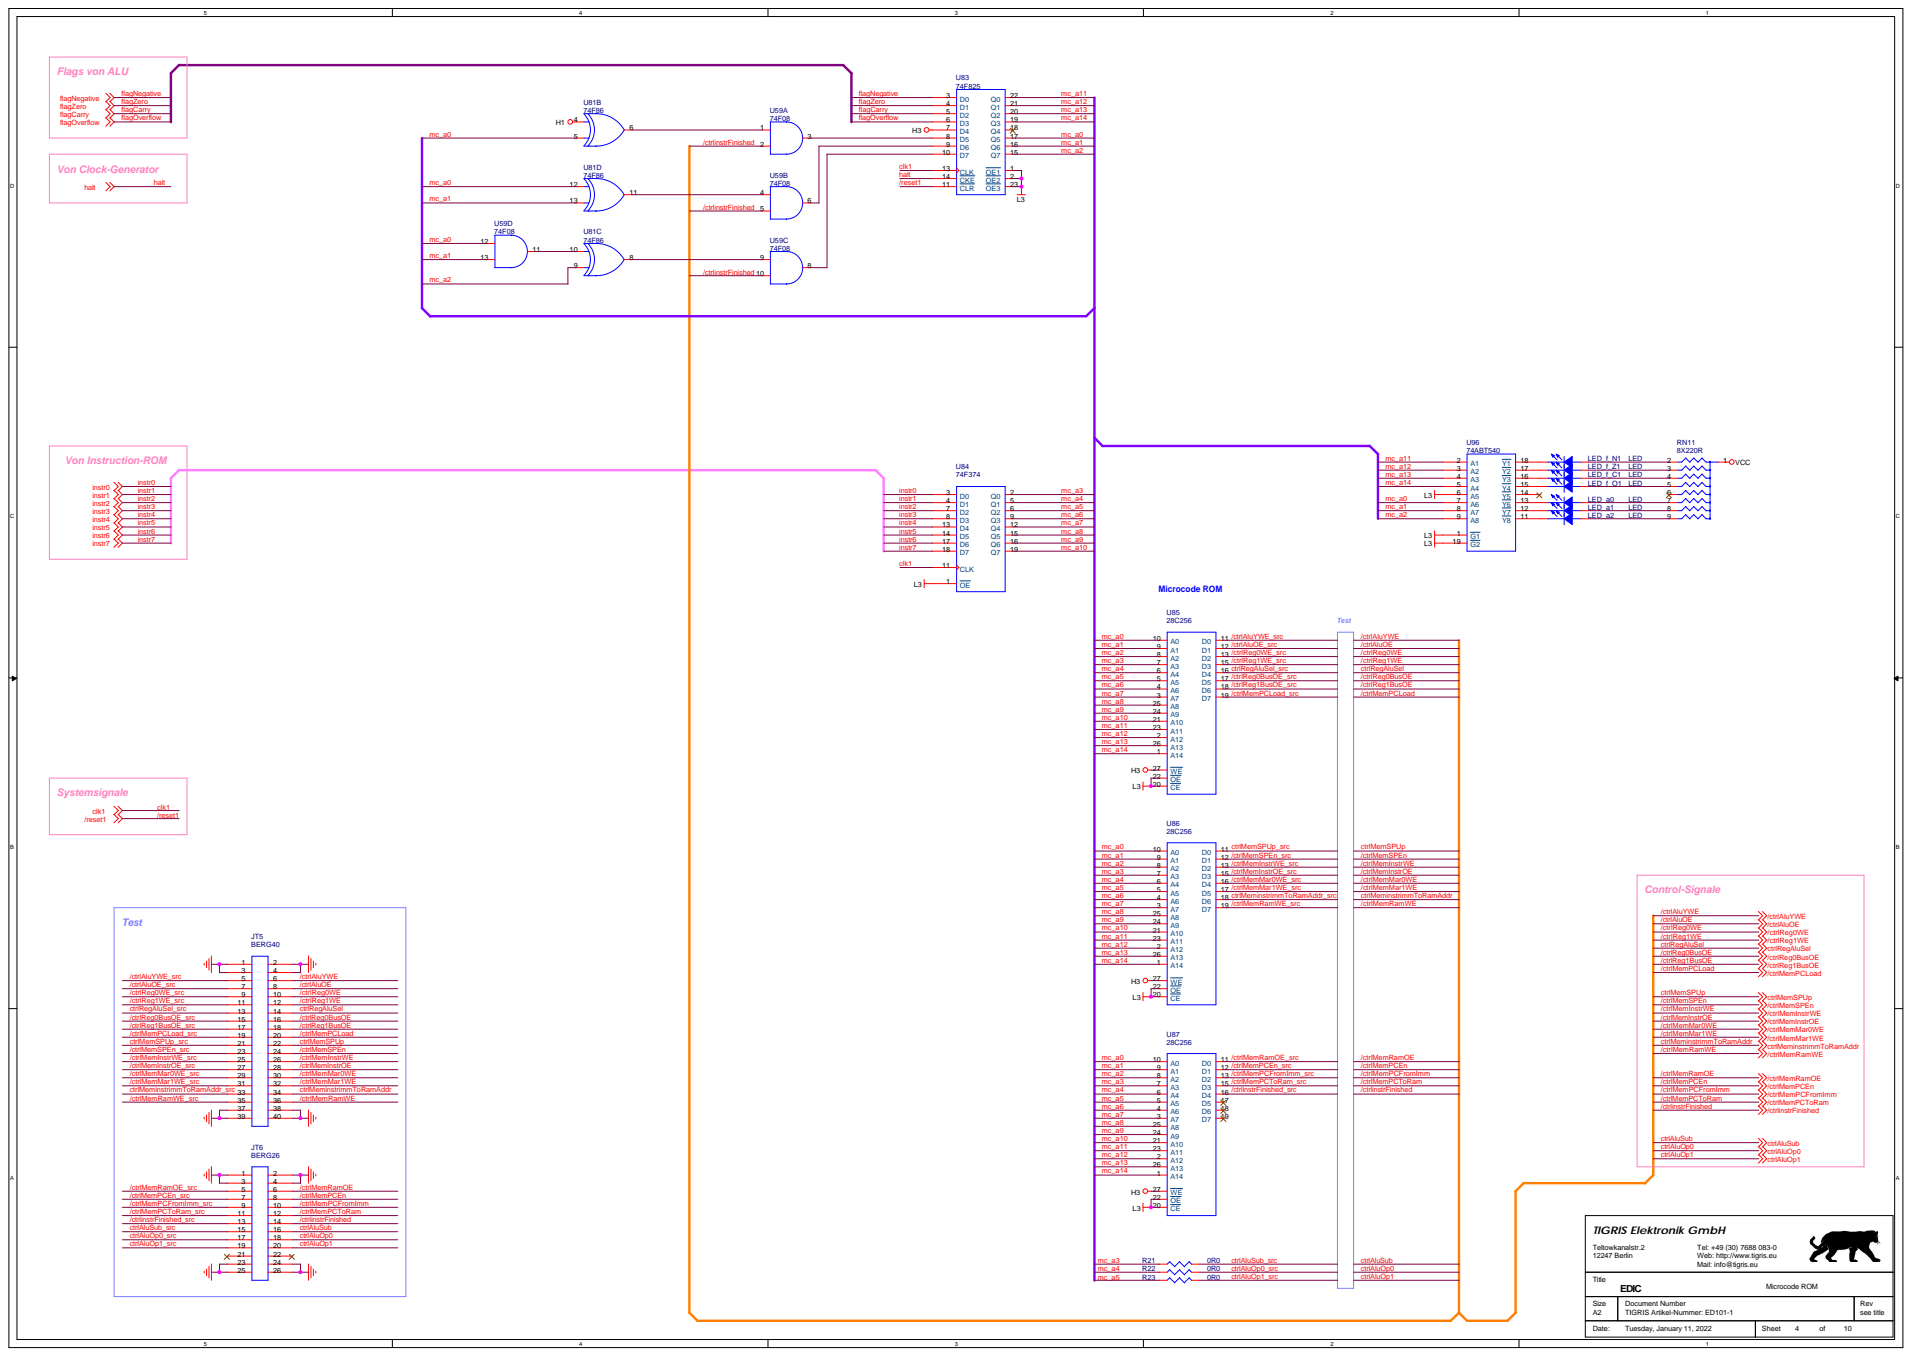
[picture p96: page 1]

mc_a12 | 17
mc_a13 | 16
mc_a14 | 15

instr4 13 | mc_a7 12
instr5 14 | 15 mc_a8

109876543 mc_a3 | /ctrlReg1WE_src 15 | /ctrlReg1WE
mc_a1 | /ctrlAluOE_src 12 | /ctrlAluOE
mc_a2 | 13 /ctrlReg0WE_src | /ctrlReg0WE

mc_a4 | 16 ctrlRegAluSel_src | ctrlRegAluSel
mc_a5 | 17 /ctrlReg0BusOE_src | /ctrlReg0BusOE

mc_a7 | 19 /ctrlMemPCLoad_src | /ctrlMemPCLoad
mc_a8 25 | | ctrlMemSPUp

109876543 mc_a2 | 13 /ctrlMemInstrWE_src | /ctrlMemInstrWE
mc_a1 | 12 /ctrlMemSPEn_src | /ctrlMemSPEn

mc_a3 | /ctrlMemInstrOE_src 15 | /ctrlMemInstrOE

mc_a5 | /ctrlMemMar1WE_src 17 | /ctrlMemMar1WE
mc_a6 | ctrlMeminstrimmToRamAddr_src 18 | ctrlMeminstrimmToRamAddr
mc_a7 | 19 /ctrlMemRamWE_src | /ctrlMemRamWE

109876543 mc_a2 | /ctrlMemPCFromImm_src 13 | /ctrlMemPCFromImm
mc_a1 | 12 /ctrlMemPCEn_src | /ctrlMemPCEn

Tel: +49 (30) 7688 083-0
Web: http://www.tigris.eu
Mail: info@tigris.eu

Size A2 | Document Number TIGRIS Artikel-Nummer: ED101-1 | Rev see title

Date: Tuesday, January 11, 2022 | Sheet 4 of 10
