Nik-Sch/EDiC/thesis/figures/schematic_7.pdf

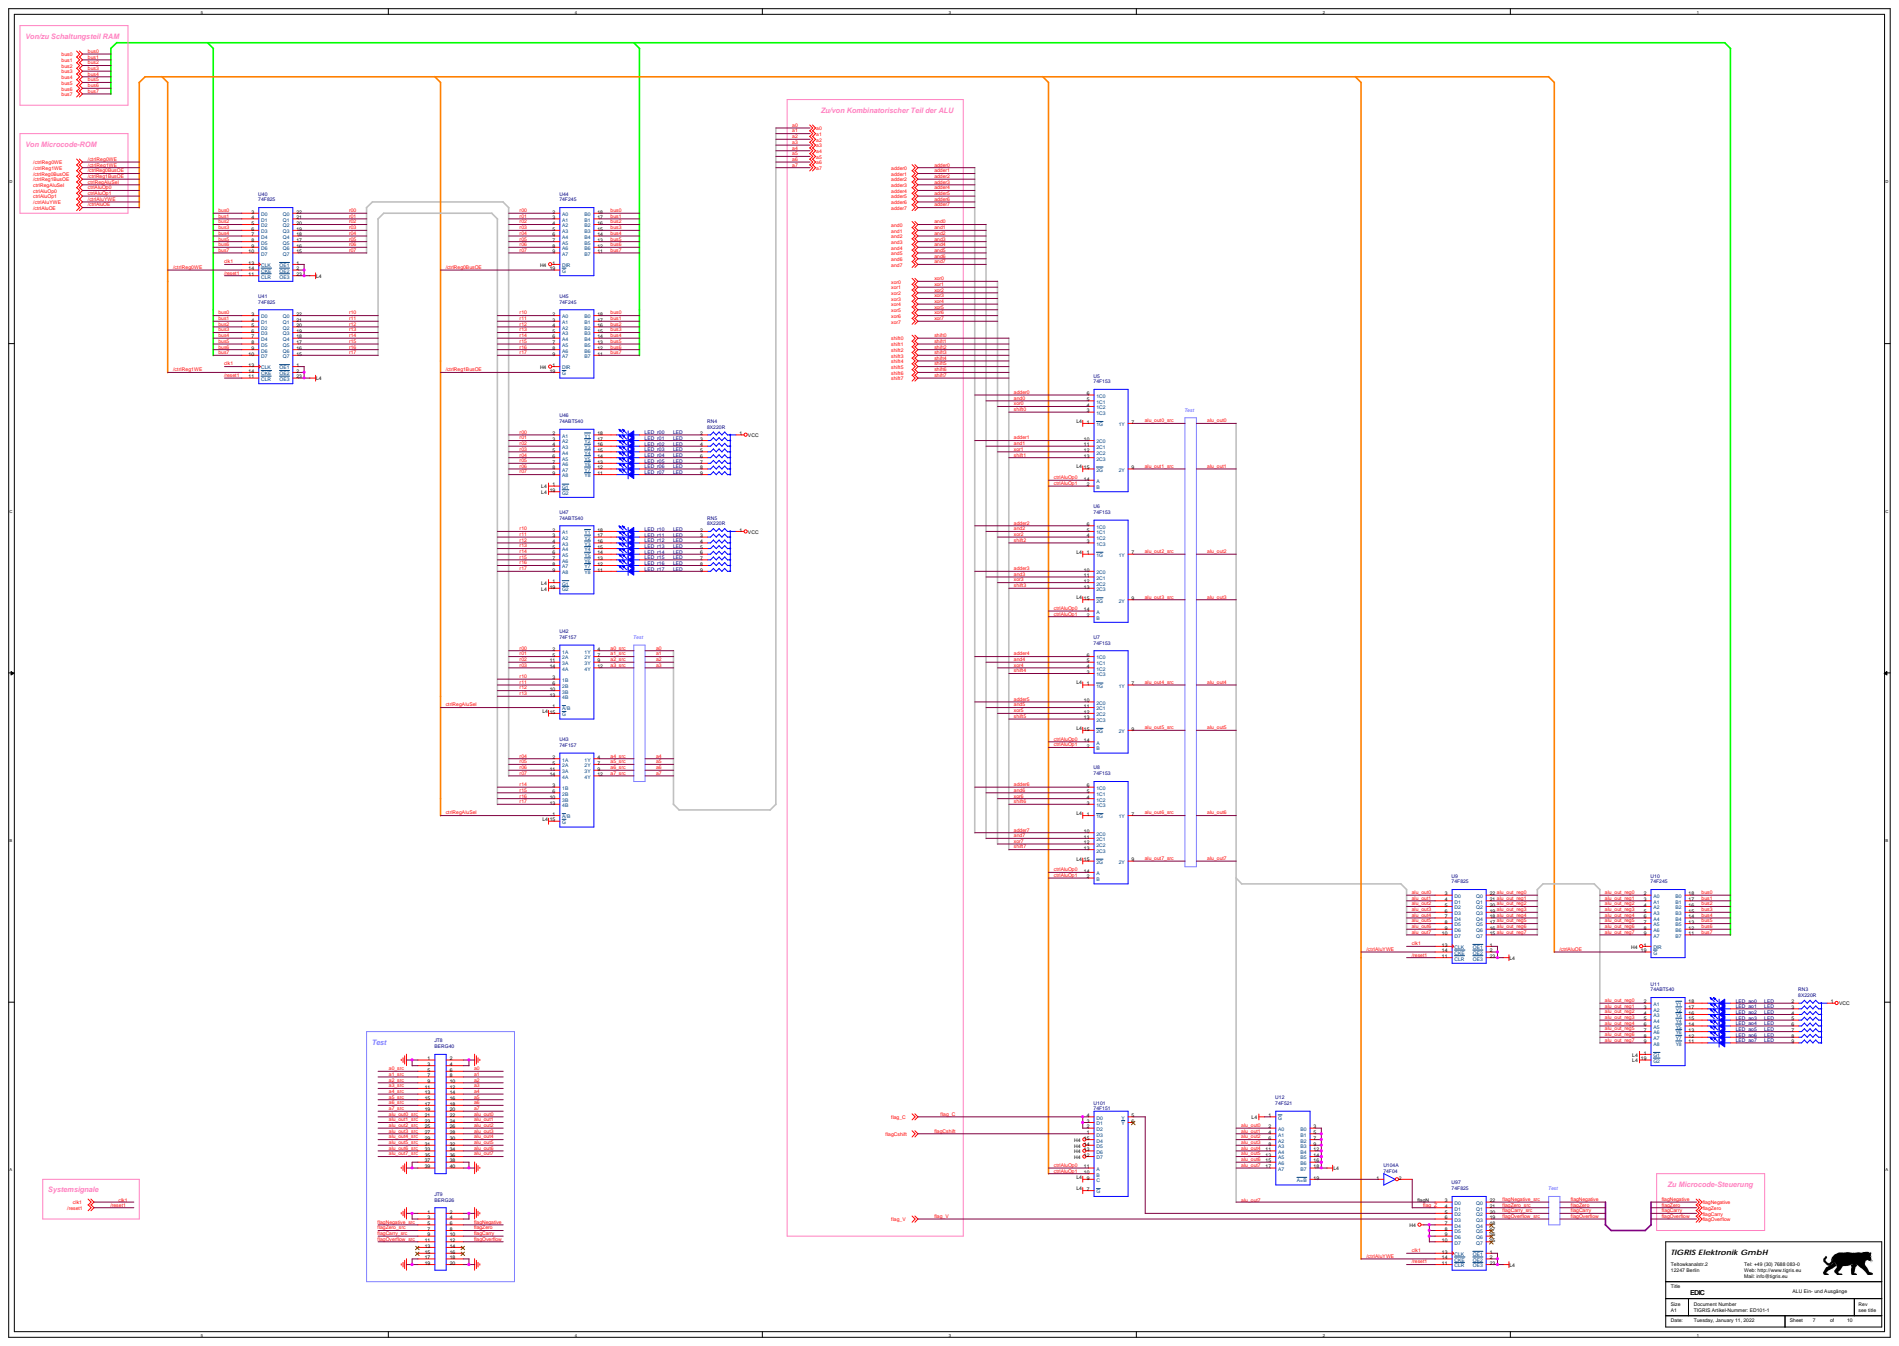
[picture p97: page 1]

Von/zu Schaltungsteil RAM

Zu/von Kombinatorischer Teil der ALU

/ctrlReg1BusOE

234567891 r13
r11
r12

r16
r17

ctrlRegAluSel

Tel: +49 (30) 7688 083-0
Web: http://www.tigris.eu
Mail: info@tigris.eu

Size A1 | Document Number TIGRIS Artikel-Nummer: ED101-1 | Rev see title

ALU Ein- und Ausgänge

Date: Tuesday, January 11, 2022 | Sheet 7 of 10
