Nik-Sch/EDiC/thesis/figures/schematic_8.pdf

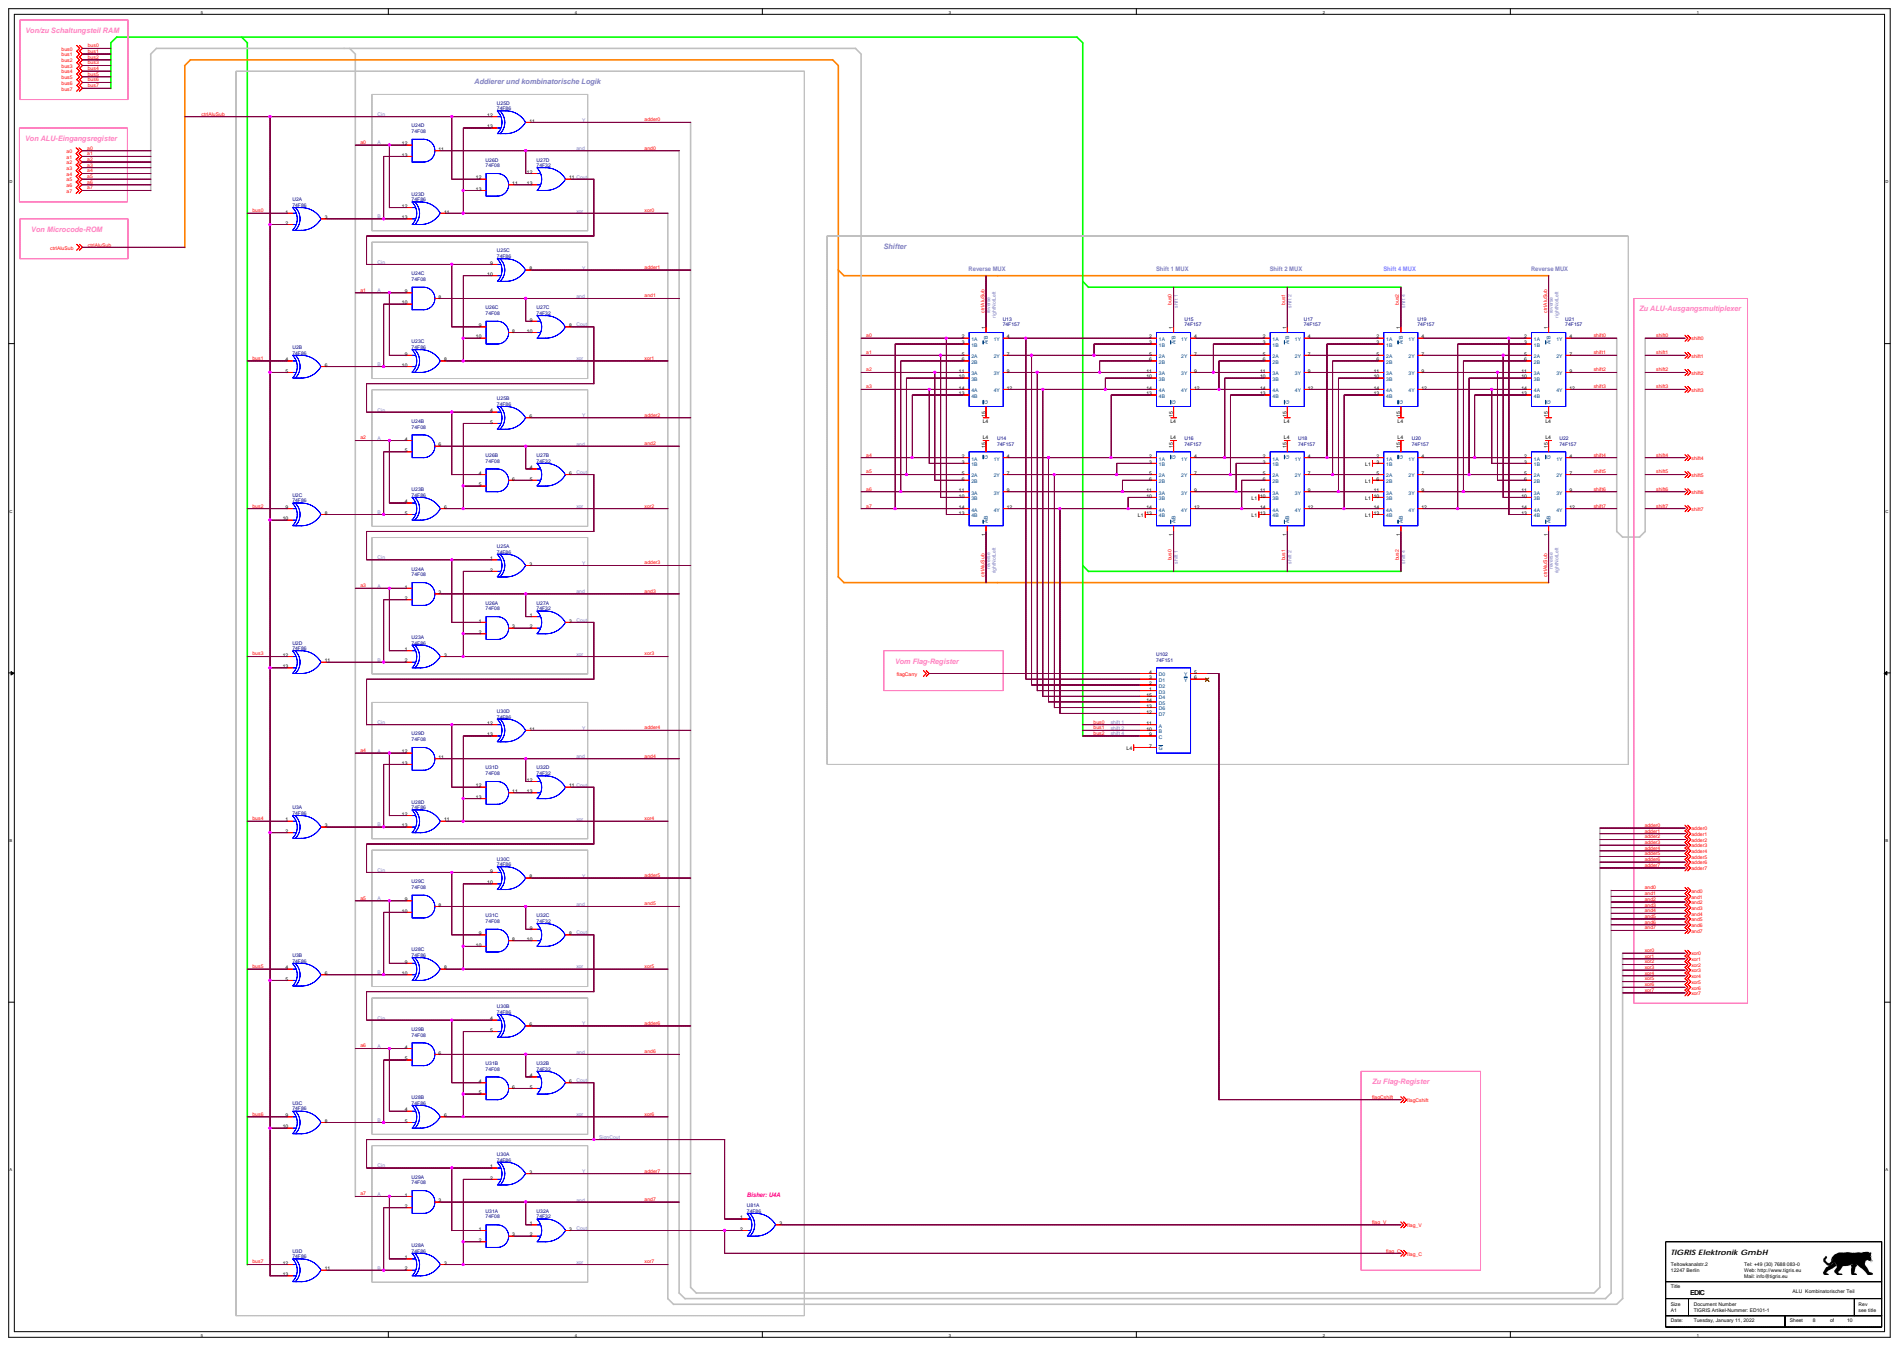
[picture p98: page 1]

Von/zu Schaltungsteil RAM

Addierer und kombinatorische Logik

Shift 1 MUX Shift 2 MUX Shift 4 MUX

15
14

Tel: +49 (30) 7688 083-0
Web: http://www.tigris.eu
Mail: info@tigris.eu

Size A1 | Document Number TIGRIS Artikel-Nummer: ED101-1 | Rev see title

Date: Tuesday, January 11, 2022 | Sheet 8 of 10
