Nik-Sch/EDiC/thesis/figures/barrel_shifter.pdf

## Shifter

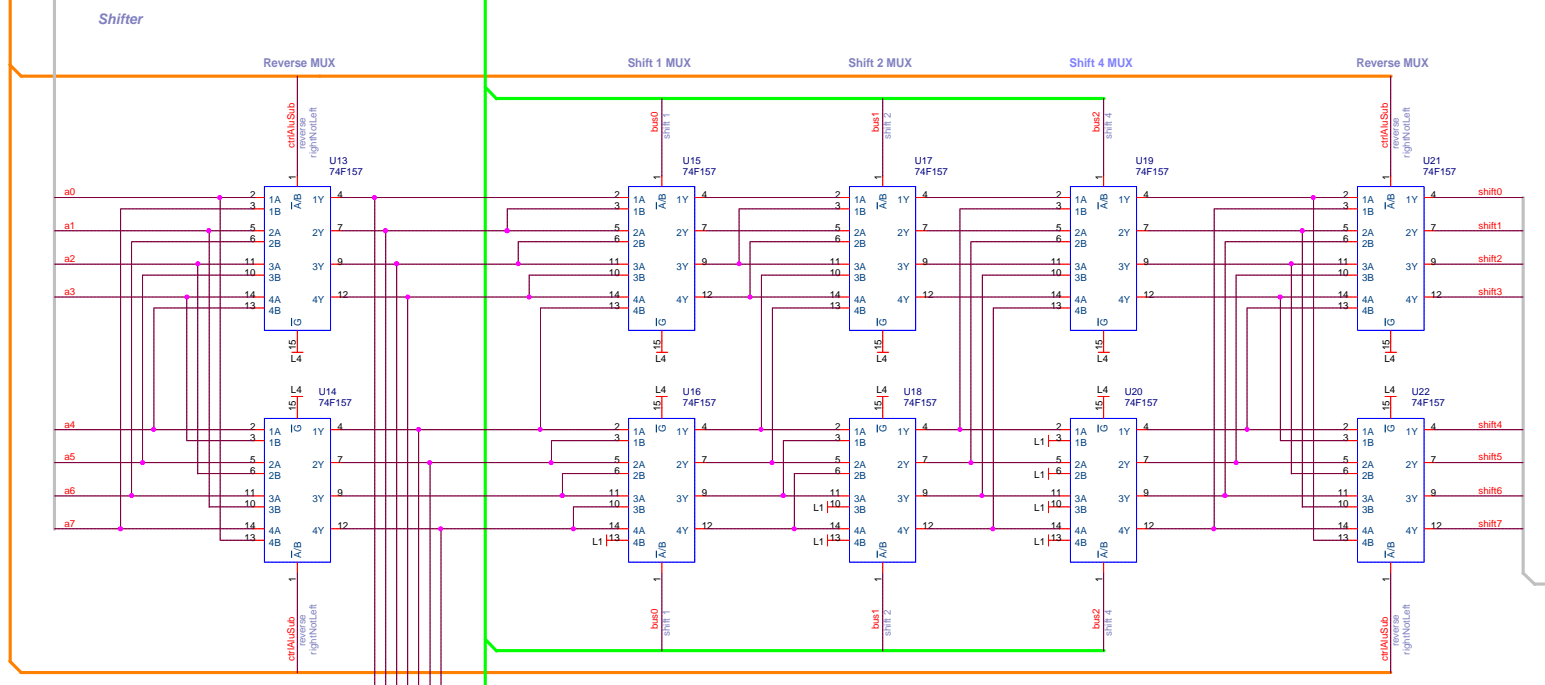
[picture p99: page 1]
