Nik-Sch/EDiC/thesis/figures/breadboardPcb.pdf

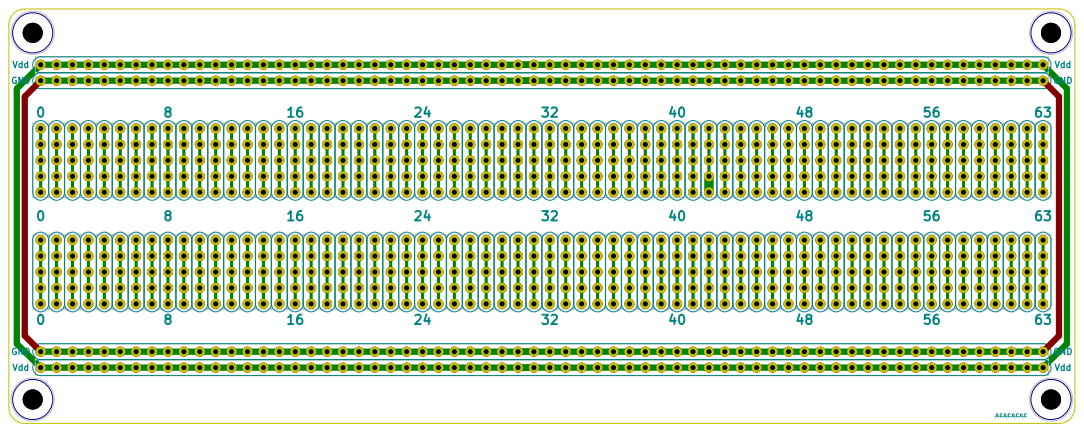
[picture p100: page 1]
