Nik-Sch/EDiC/thesis/figures/DFlipFlop.pdf

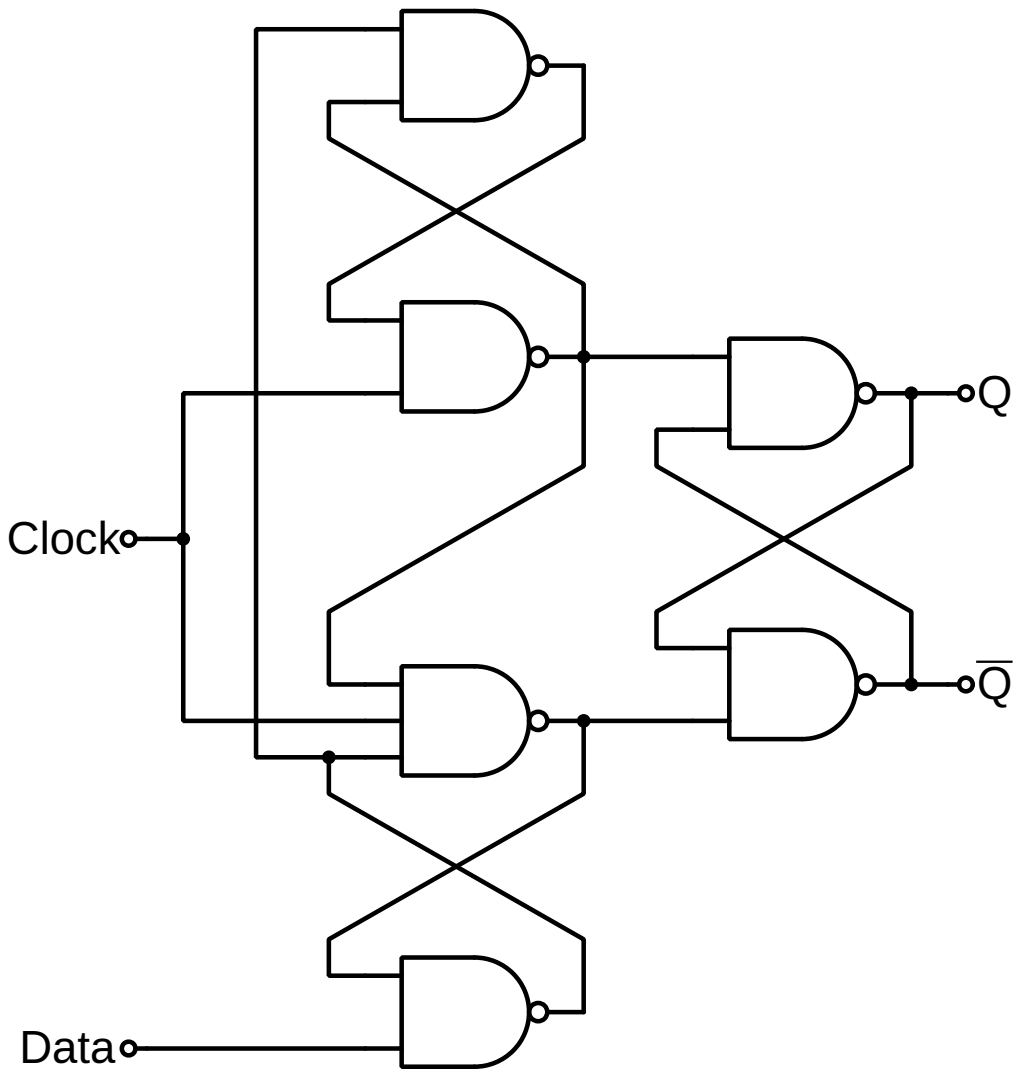
[picture p101: page 1]
Clo
