Nik-Sch/EDiC/thesis/figures/DFlipFlopClearSet.pdf

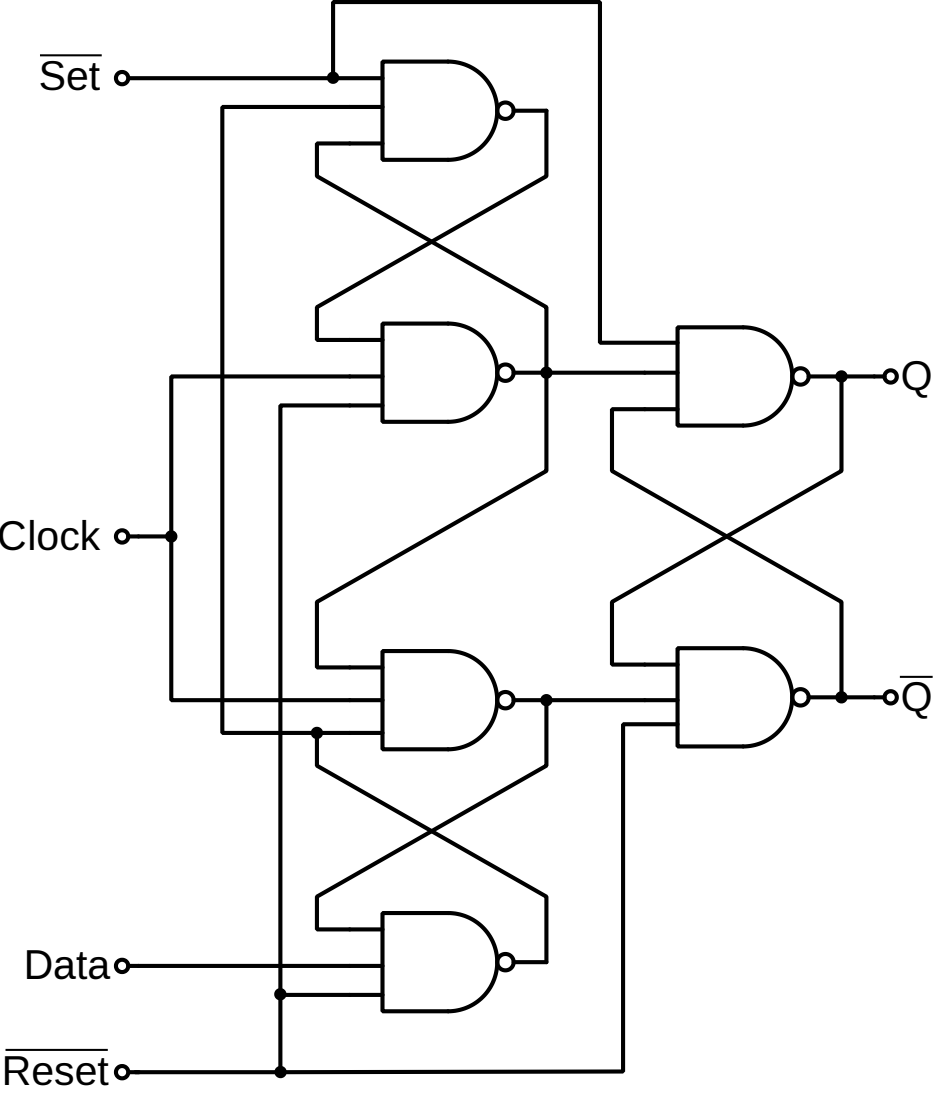
[picture p102: page 1]
Clo
