Nik-Sch/EDiC/thesis/figures/full_adder.pdf

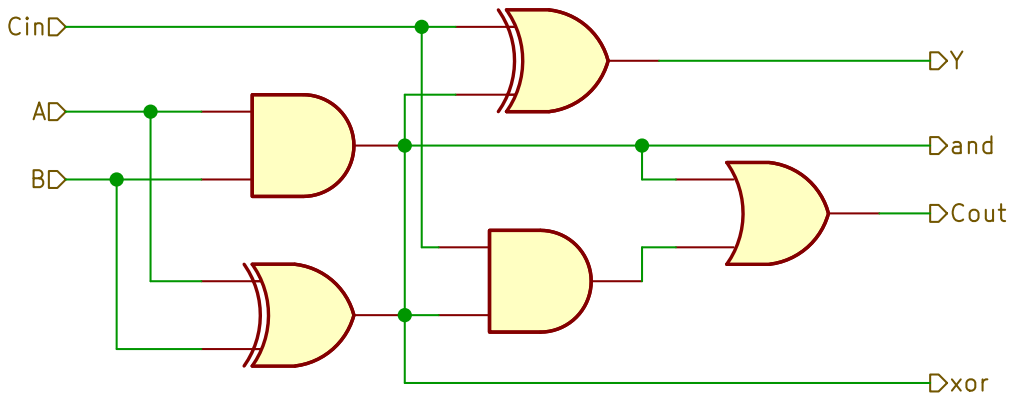
[picture p103: page 1]
xor Y

and Cout A CinB
