Nik-Sch/EDiC/thesis/figures/regset.pdf

15 | VCC ¹⁶
15 | VCC ¹⁶

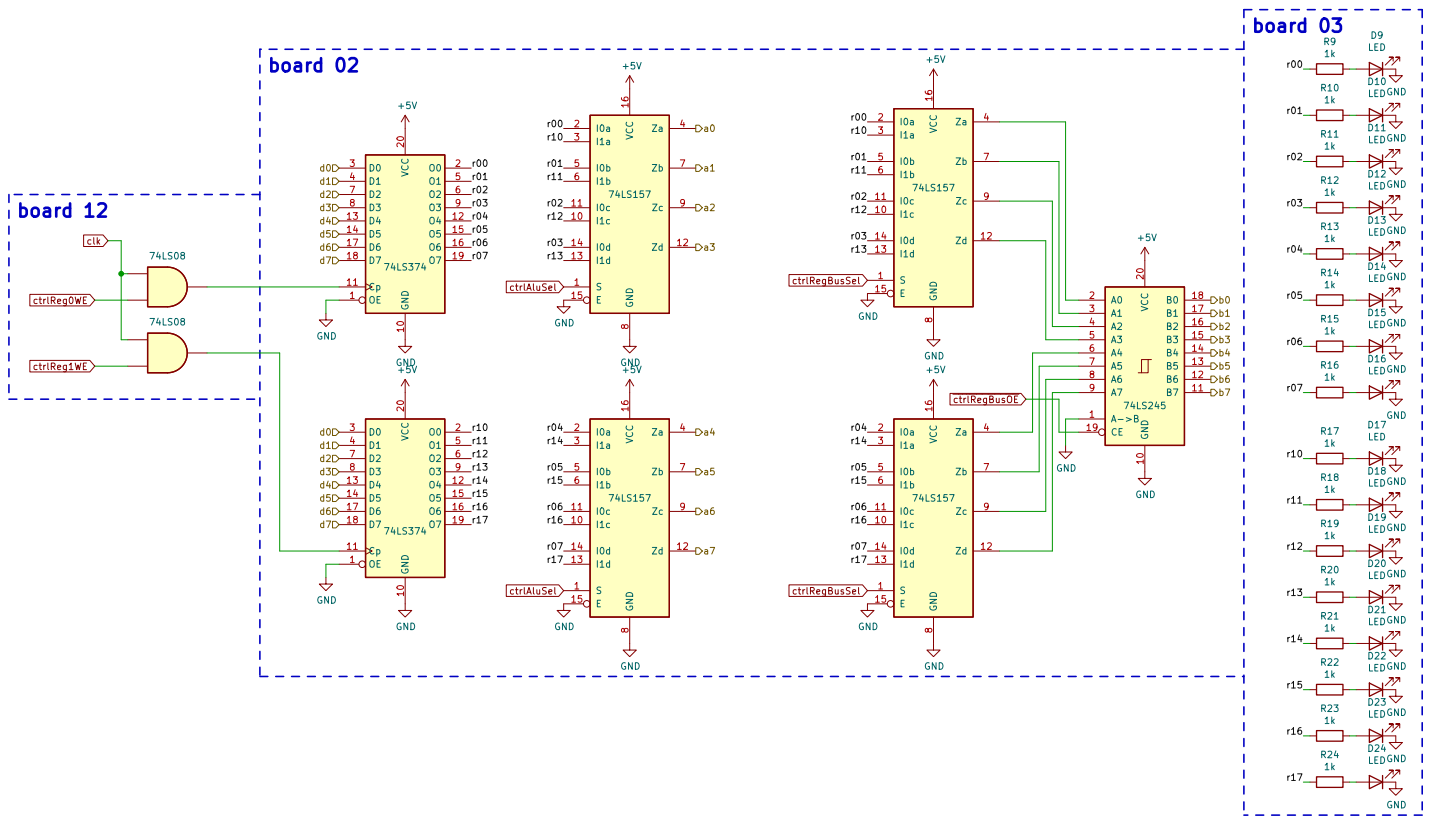
[picture p104: page 1]
