Nik-Sch/EDiC/thesis/logos/tigris_logo.pdf

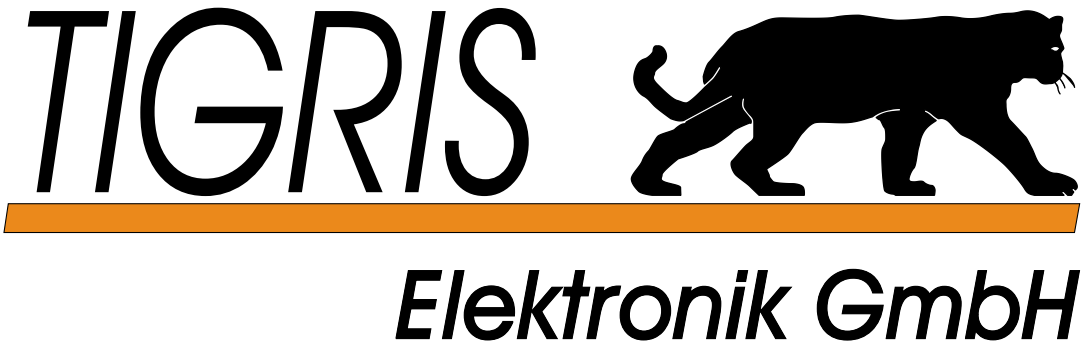
[picture p105: page 1]
