Nik-Sch/EDiC/netlist_parser/netlists_henry/ED-101_102_Schaltplan_Rev.0.00.05_2022-01-11.pdf

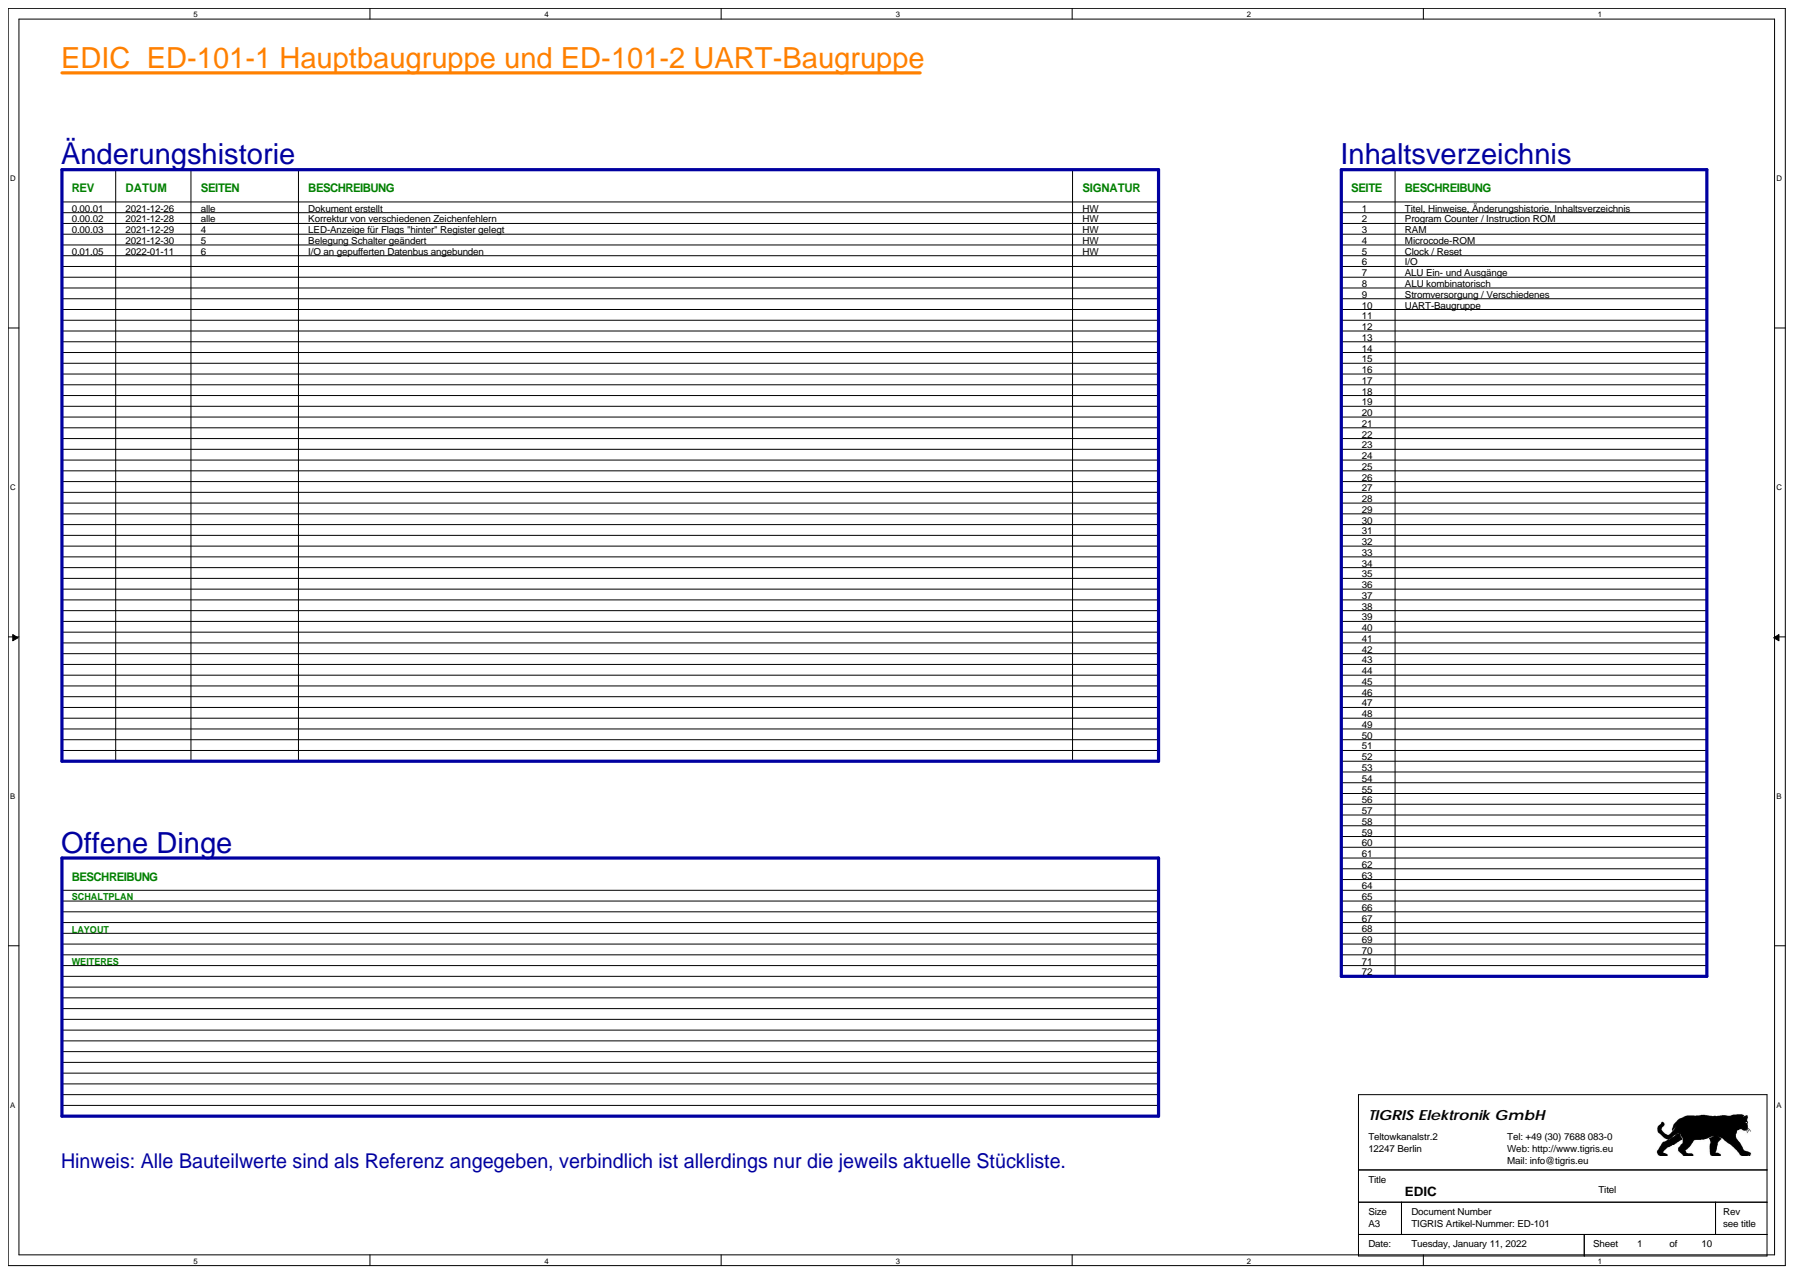
[picture p116: page 1]

EDIC ED-101-1 Hauptbaugruppe und ED-101-2 UART-Baugruppe

Titel, Hinweise, Änderungshistorie, Inhaltsverzeichnis
Program Counter / Instruction ROM
RAM
Microcode-ROM
Clock / Reset

6 | I/O
7 | ALU Ein- und Ausgänge
8 | ALU kombinatorisch
9 | Stromversorgung / Verschiedenes
10 | UART-Baugruppe
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
Tel: +49 (30) 7688 083-0
Web: http://www.tigris.eu
Mail: info@tigris.eu

Hinweis: Alle Bauteilwerte sind als Referenz angegeben, verbindlich ist allerdings nur die jeweils aktuelle Stückliste.

Size A3 | Document Number TIGRIS Artikel-Nummer: ED-101 | Rev see title

Date: Tuesday, January 11, 2022 | Sheet 1 of 10


instr_unreg0 | clk1 /ctrlMeminstrWE 13 14 | instrimm5

instr_unreg2 | 3456789 | 20 instr2
instr_unreg1 | | 21 instr1

Tel: +49 (30) 7688 083-0
Web: http://www.tigris.eu
Mail: info@tigris.eu

Program Counter / Instruction ROM

TIGRIS Artikel-Nummer: ED101-1 | see title
Tuesday, January 11, 2022


U65 74F245 | /ctrlMemRamWE 4

ramAddress_buf10 23 | | 14 bus_buf1

ramAddress_buf12 4 | | bus_buf3 17
ramAddress_buf13 28 | | bus_buf4 18
ramAddress_buf14 3 | | 19 bus_buf5
ramAddress_buf15 31 | | 20 bus_buf6

2 | | 21 bus_buf7

/ctrlMemRamWE_buf | 30 L2 1 L2 29

/ctrlMemRamOE_buf | 24

/ramCE_buf

/ctrlMemRamOE_buf

RAM2 RN33 8X10K U100

Pull-Up an ramAddress 15..0

CMOS-Buffer für RAM und I/O


mc_a12 | 17
mc_a13 | 16
mc_a14 | 15

instr4 13 | mc_a7 12
instr5 14 | 15 mc_a8

109876543 mc_a3 | /ctrlReg1WE_src 15 | /ctrlReg1WE
mc_a1 | /ctrlAluOE_src 12 | /ctrlAluOE
mc_a2 | 13 /ctrlReg0WE_src | /ctrlReg0WE

mc_a4 | 16 ctrlRegAluSel_src | ctrlRegAluSel
mc_a5 | 17 /ctrlReg0BusOE_src | /ctrlReg0BusOE

mc_a7 | 19 /ctrlMemPCLoad_src | /ctrlMemPCLoad
mc_a8 25 | | ctrlMemSPUp

109876543 mc_a2 | 13 /ctrlMemInstrWE_src | /ctrlMemInstrWE
mc_a1 | 12 /ctrlMemSPEn_src | /ctrlMemSPEn

mc_a3 | /ctrlMemInstrOE_src 15 | /ctrlMemInstrOE

mc_a5 | /ctrlMemMar1WE_src 17 | /ctrlMemMar1WE
mc_a6 | ctrlMeminstrimmToRamAddr_src 18 | ctrlMeminstrimmToRamAddr
mc_a7 | 19 /ctrlMemRamWE_src | /ctrlMemRamWE

109876543 mc_a2 | /ctrlMemPCFromImm_src 13 | /ctrlMemPCFromImm
mc_a1 | 12 /ctrlMemPCEn_src | /ctrlMemPCEn

Tel: +49 (30) 7688 083-0
Web: http://www.tigris.eu
Mail: info@tigris.eu


Zu/von Program Counter/Instr-ROM

Geschlossen: Normalbetrieb (Breakpoint unwirksam)
Offen: Breakpoint wirksam

Logik für Waitstaes und Break

Tel: +49 (30) 7688 083-0
Web: http://www.tigris.eu
Mail: info@tigris.eu

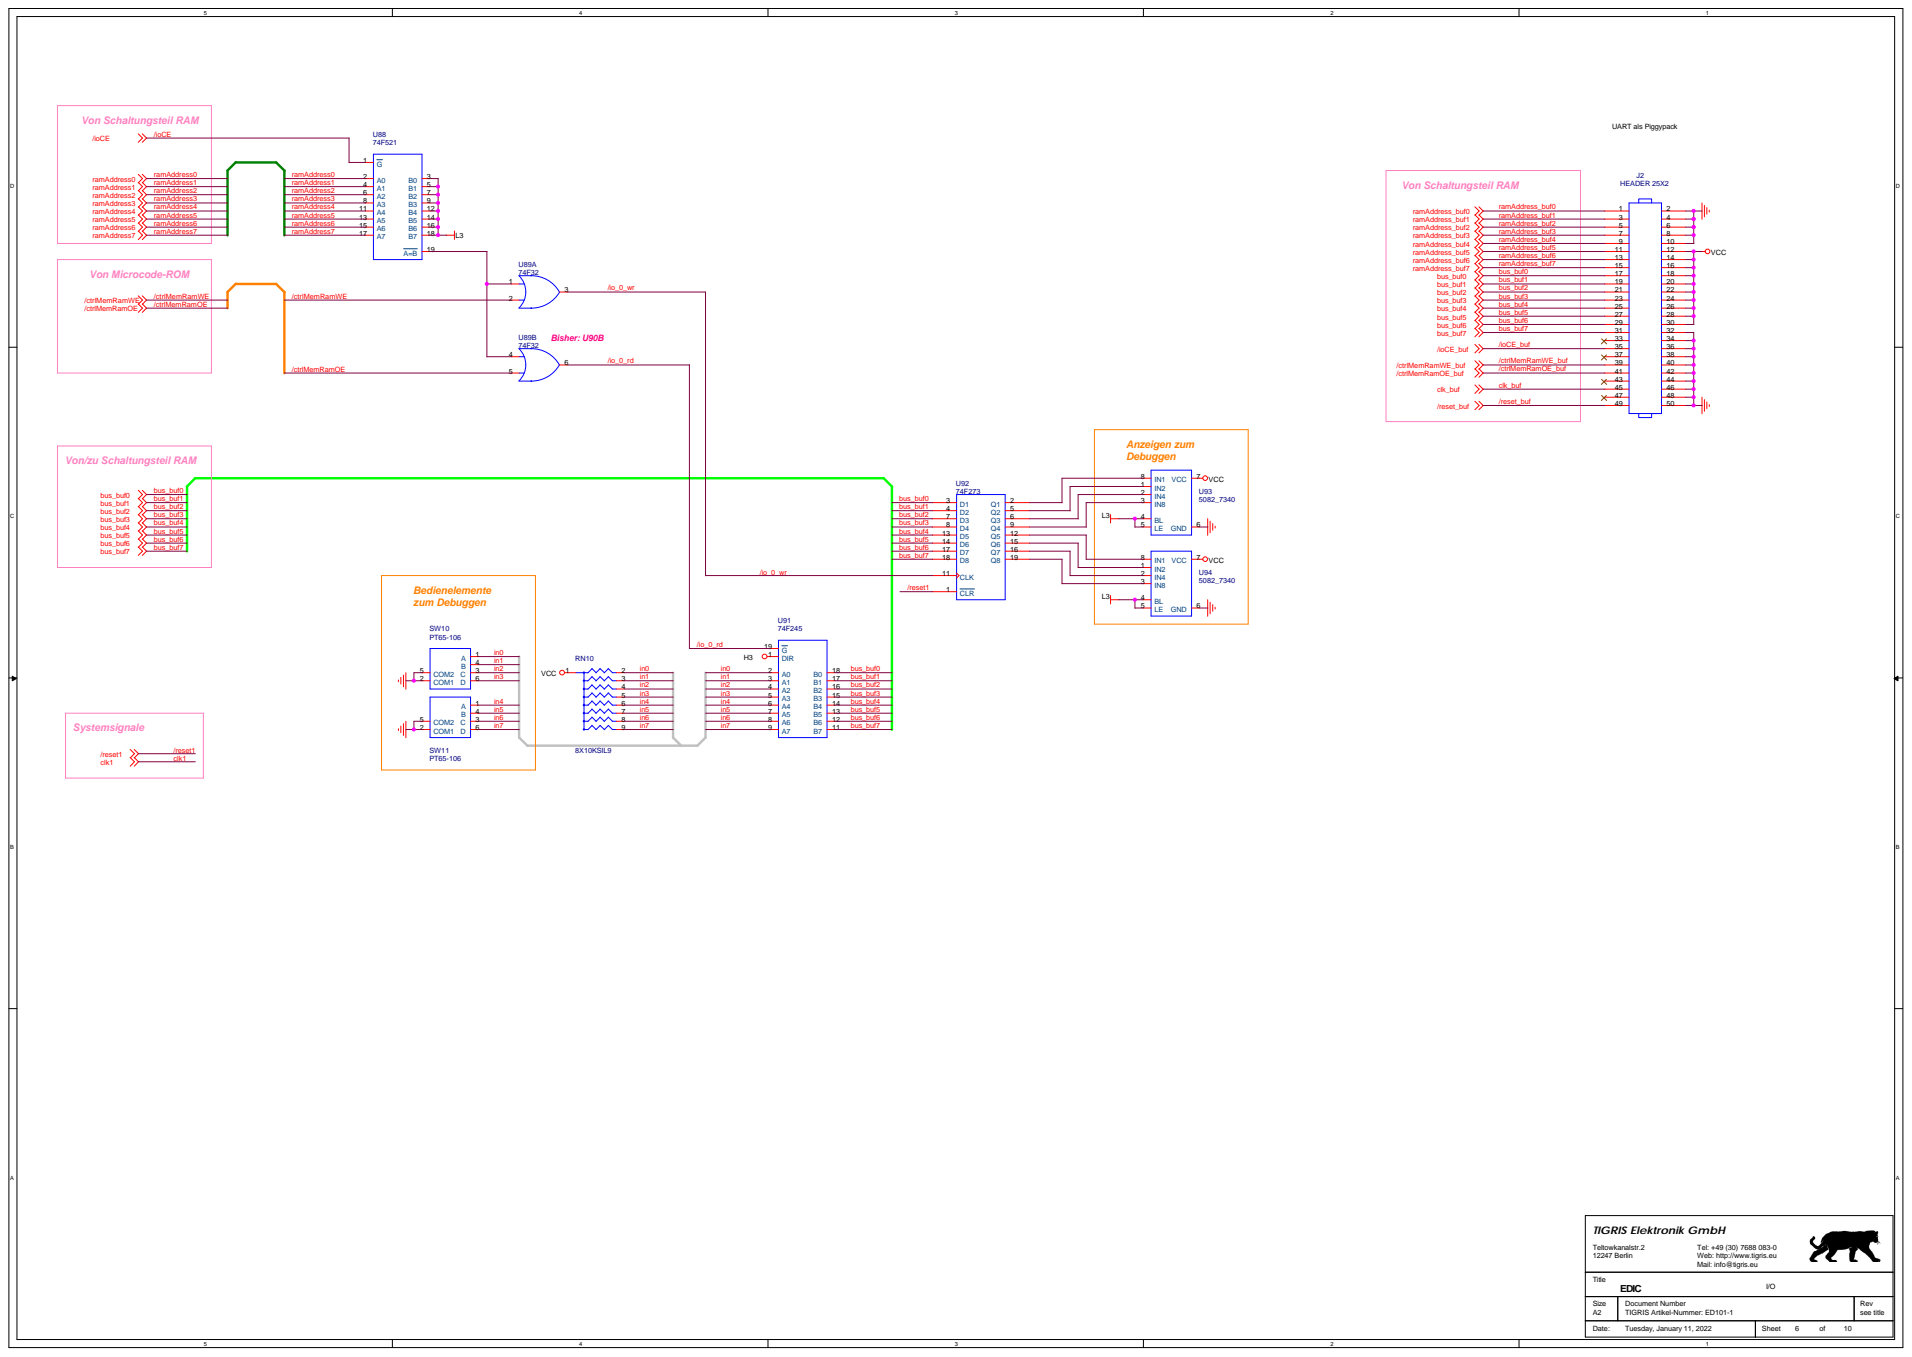
[picture p117: page 6]

ramAddress1 4 | 5
ramAddress2 6 | 7
ramAddress3 8 | 9
ramAddress4 11 | 12

Von/zu Schaltungsteil RAM

1 | IN1 VCC U92

bus_buf1 4 | 5
bus_buf2 7 | 6
bus_buf3 8 | 9
bus_buf4 13 | 12
bus_buf5 14 | 15
bus_buf6 17 | 16

Tel: +49 (30) 7688 083-0
Web: http://www.tigris.eu
Mail: info@tigris.eu


Von/zu Schaltungsteil RAM

Zu/von Kombinatorischer Teil der ALU

/ctrlReg1BusOE

234567891 r13
r11
r12

r16
r17

ctrlRegAluSel

ALU Ein- und Ausgänge


Von/zu Schaltungsteil RAM

Addierer und kombinatorische Logik

Shift 1 MUX Shift 2 MUX Shift 4 MUX

15
14

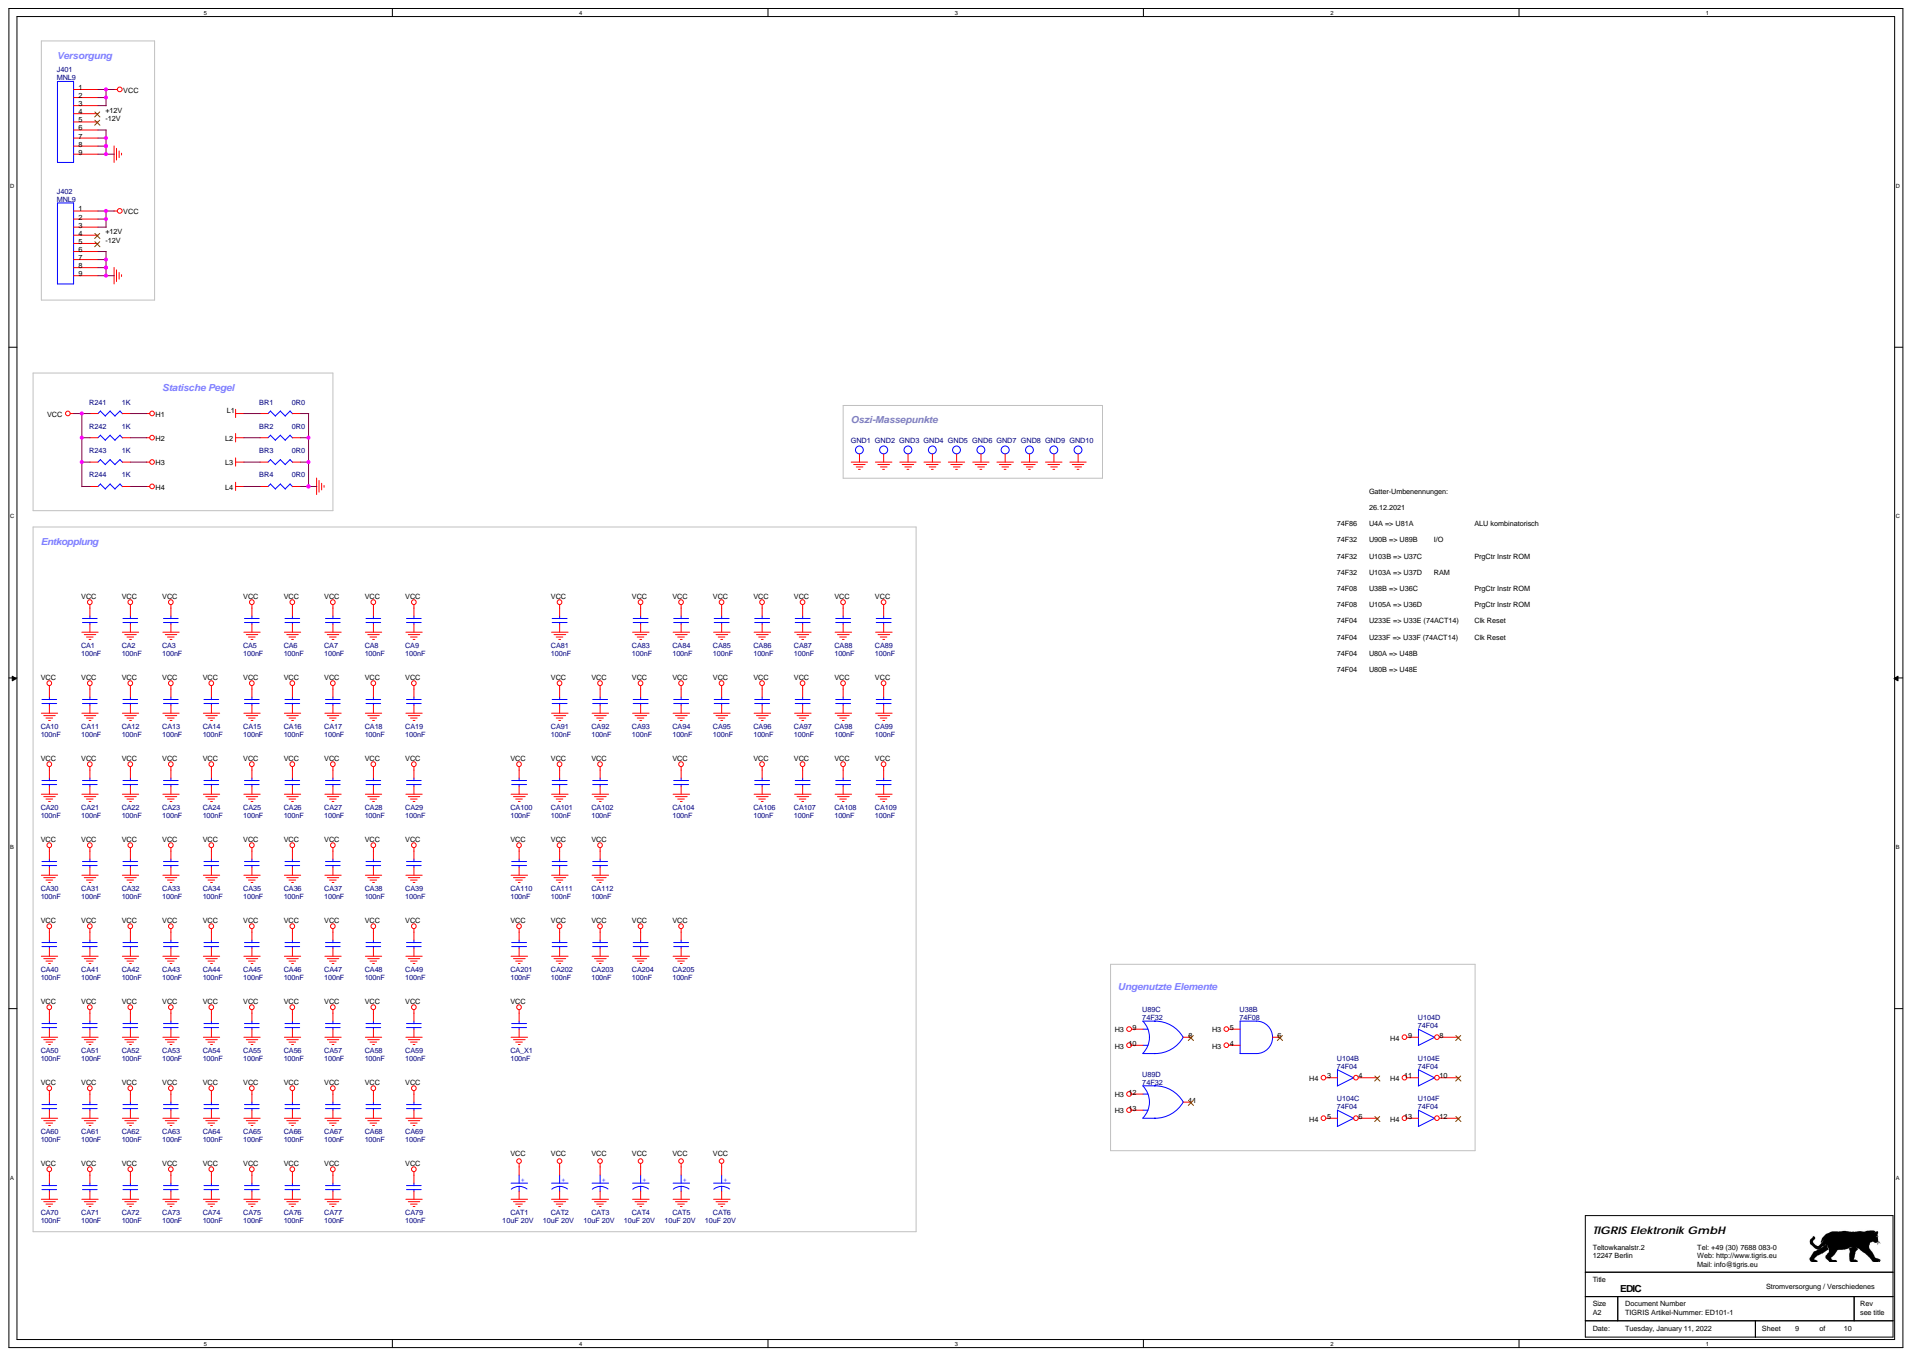
[picture p118: page 9]

Tel: +49 (30) 7688 083-0
Web: http://www.tigris.eu
Mail: info@tigris.eu

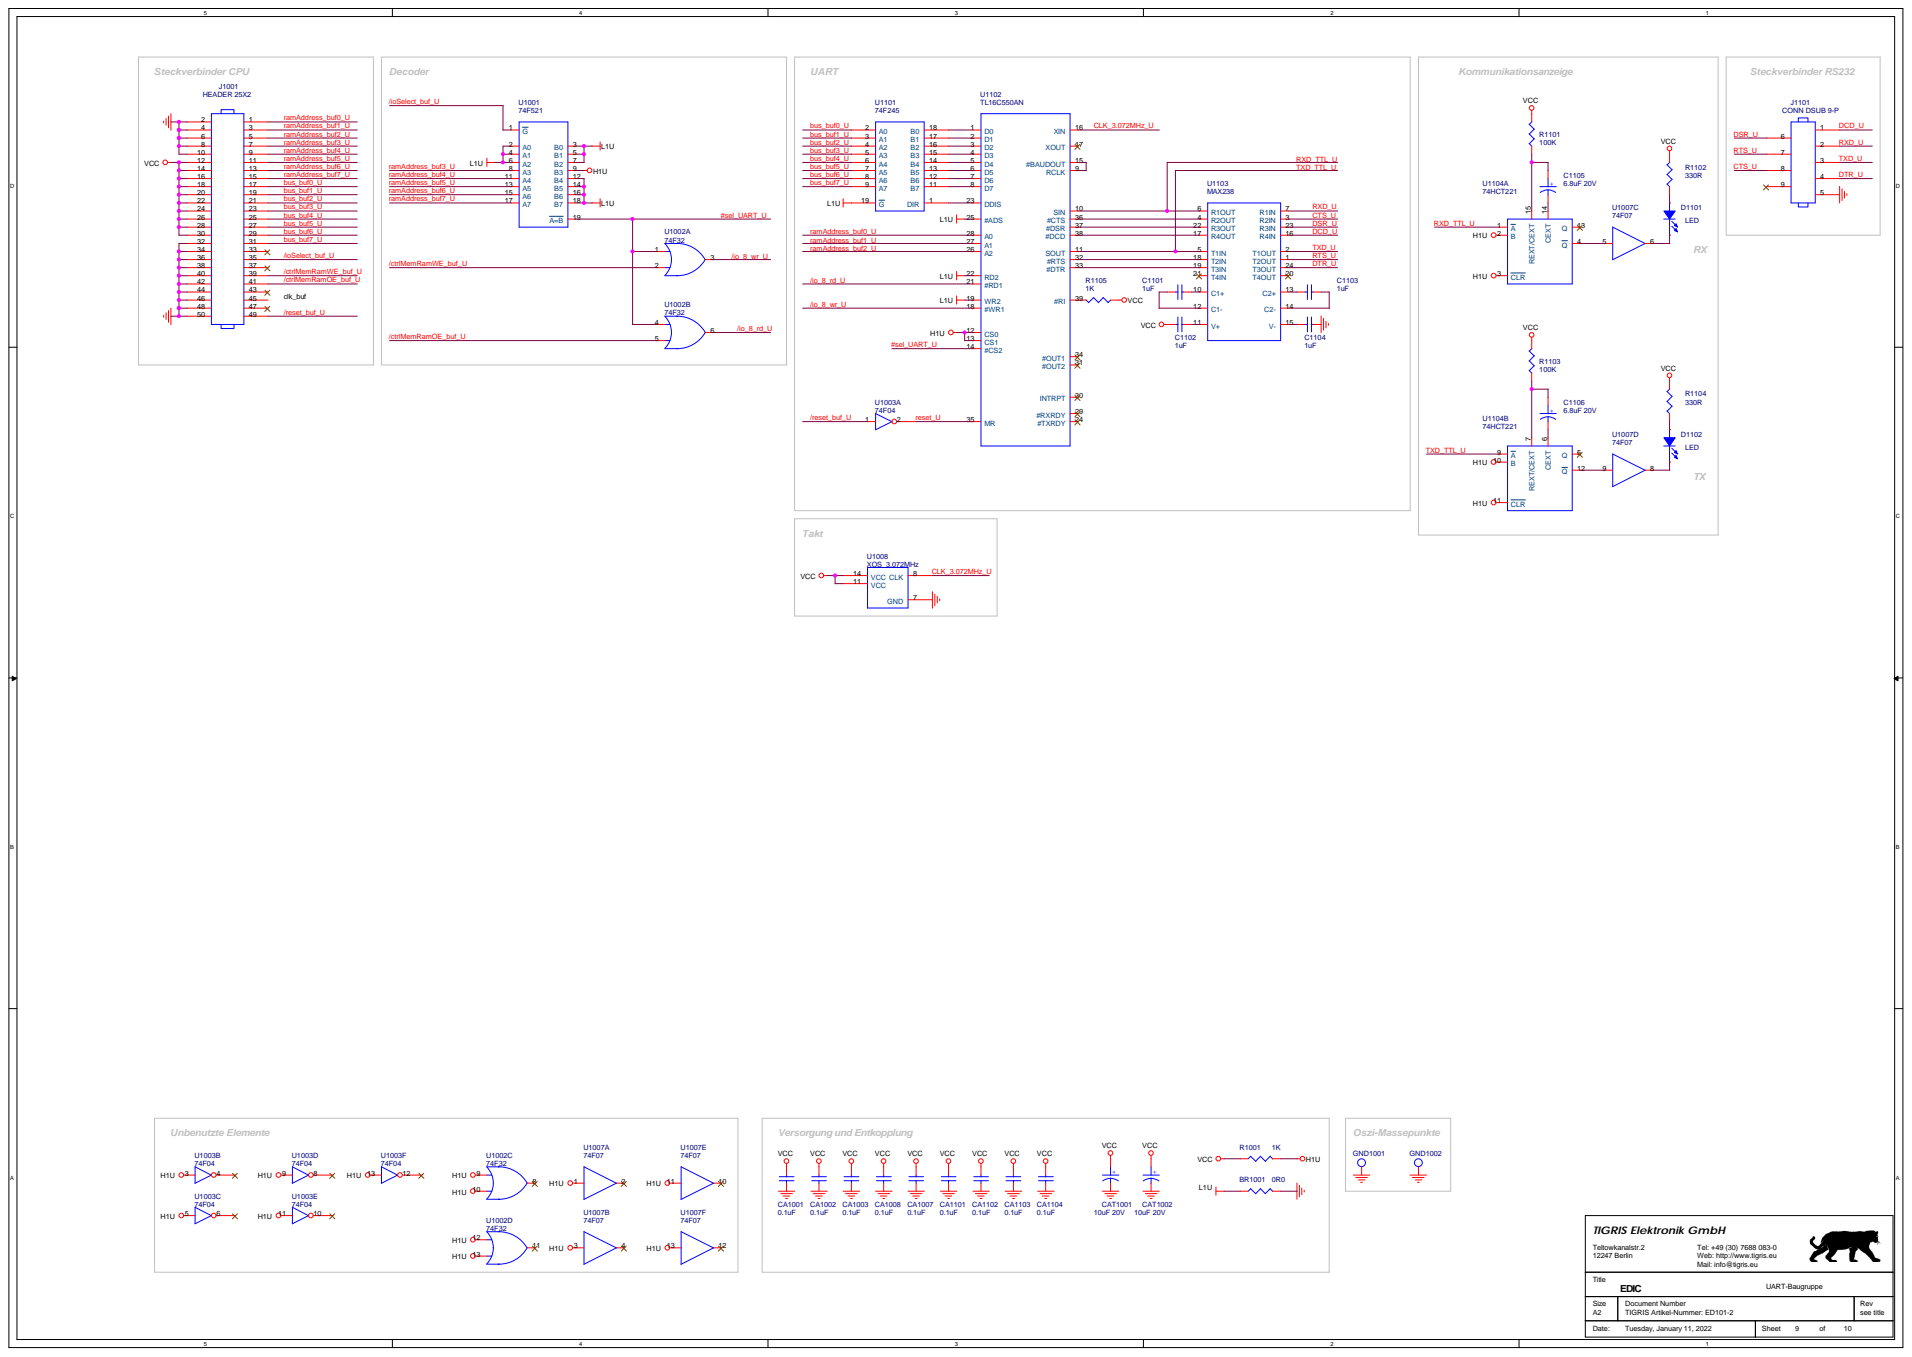
[picture p119: page 10]

Tel: +49 (30) 7688 083-0
Web: http://www.tigris.eu
Mail: info@tigris.eu

TIGRIS Artikel-Nummer: ED101-2 | see title
Tuesday, January 11, 2022 | 9 10
