Nik-Sch/EDiC/doc/docHenry/newMemory_untested.pdf

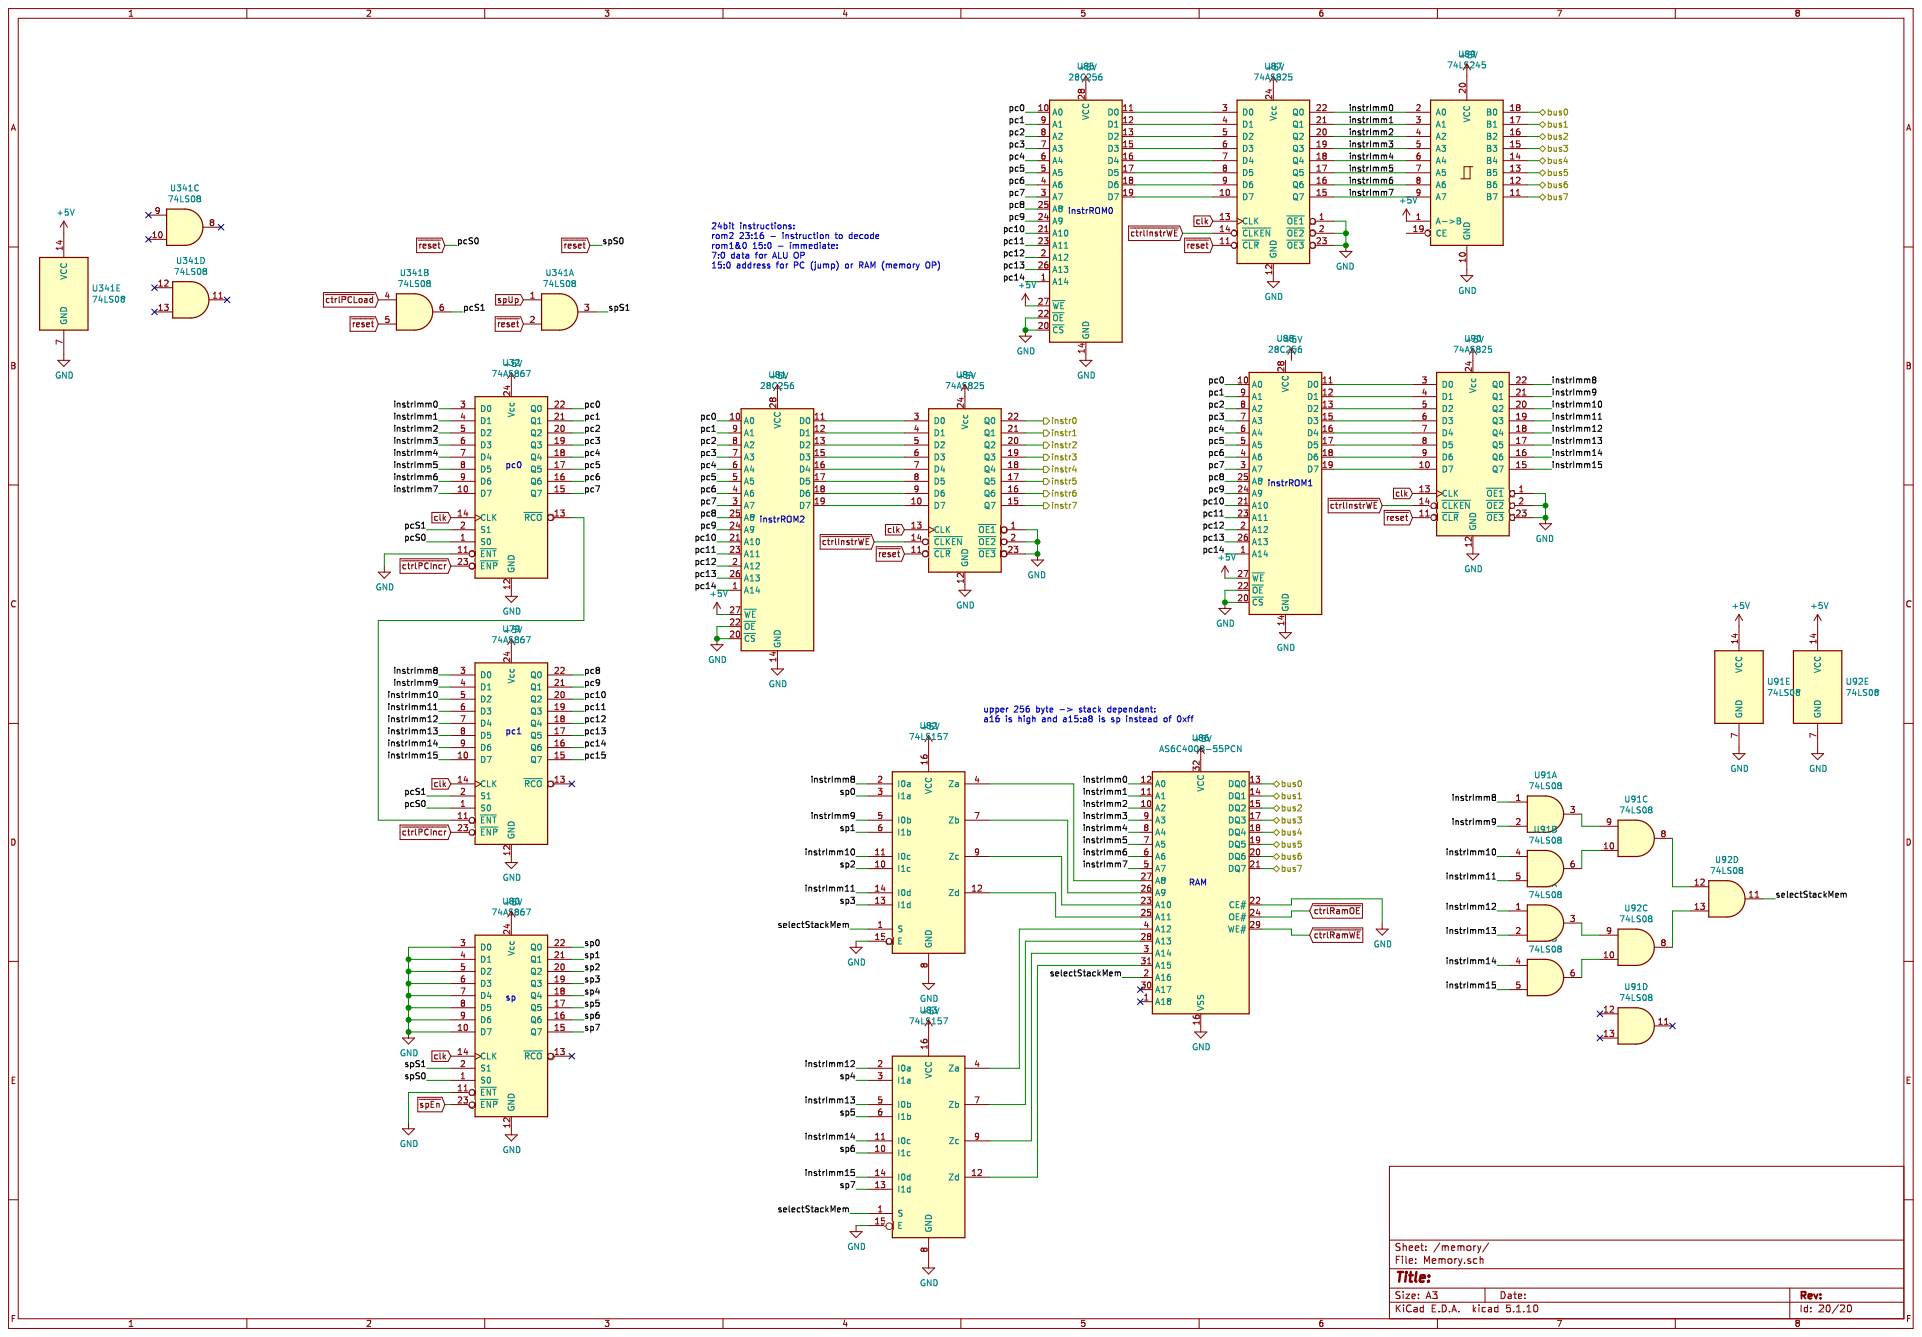
[picture p120: page 1]
