Nik-Sch/EDiC/schematic/CPU-Poster/EDiCPoster.kicad_pcb

## KiCad design schematic/CPU-Poster/EDiCPoster.kicad_pcb (2021-01-30)

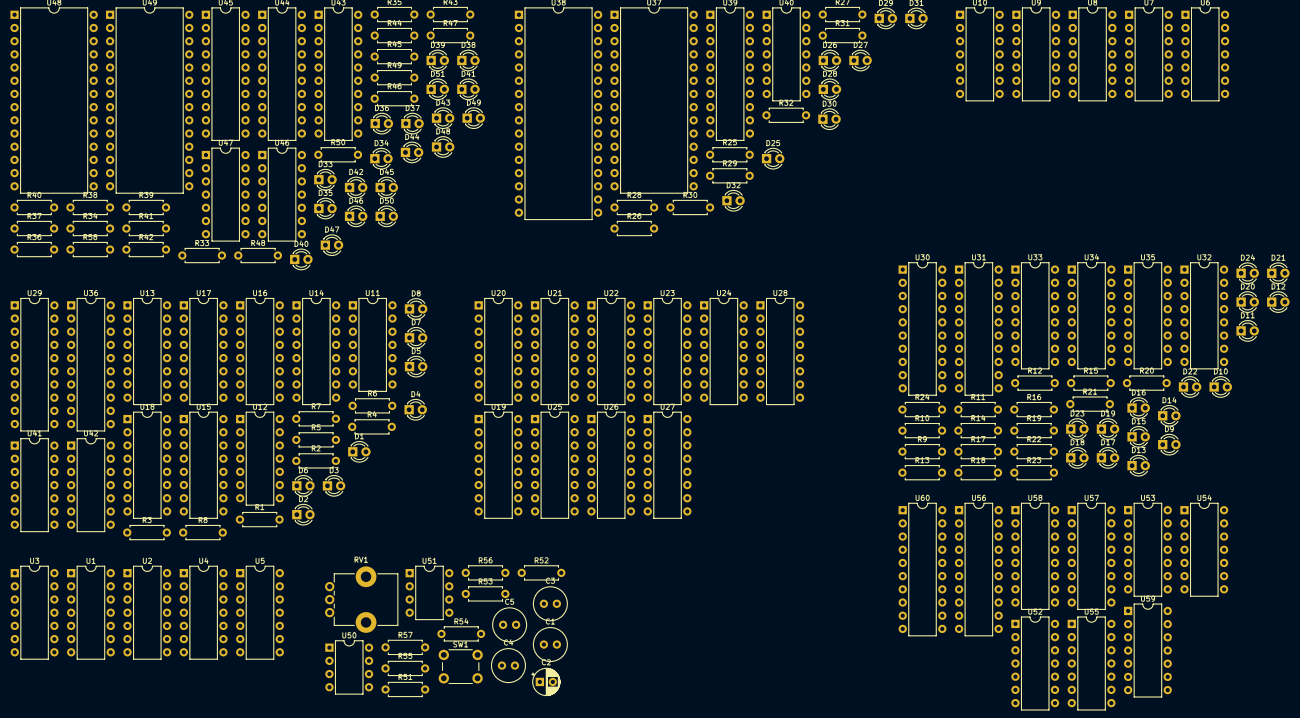
[picture p121: board EDiCPoster.kicad_pcb from above]

Board: 2 copper layers, 176 parts (0 on the bottom side), 306 nets, no tracks yet.

Parts:
C1, C3: 0.01u; C_Radial_D6.3mm_H5.0mm_P2.50mm
C2: 0.1u; CP_Radial_D5.0mm_P2.50mm
C4, C5: 0.1u; C_Radial_D6.3mm_H5.0mm_P2.50mm
D1, D2, D3, D4, D5, D6, D7, D8, D9, D10, D11, D12, D13, D14, D15, D16, D17, D18, D19, D20, D21, D22, D23, D24, D25, D26, D27, D28, D29, D30, D31, D32, D45, D47, D48, D49, D50: LED; LED_D3.0mm
D33, D51: instrNWE; LED_D3.0mm
D34: instrSel; LED_D3.0mm
D35: aluNOE; LED_D3.0mm
D36: aluYNWE; LED_D3.0mm
D37: reg0NWE; LED_D3.0mm
D38: reg1NWE; LED_D3.0mm
D39: regBusSel; LED_D3.0mm
D40: regBusNOE; LED_D3.0mm
D41: aluSel; LED_D3.0mm
D42: marNWE; LED_D3.0mm
D43: ramWE; LED_D3.0mm
D44: ramOE; LED_D3.0mm
D46: ramSelect; LED_D3.0mm
R1, R2, R3, R4, R5, R6, R7, R8, R9, R10, R11, R12, R13, R14, R15, R16, R17, R18, R19, R20, R21, R22, R23, R24, R25, R26, R27, R28, R29, R30, R31, R32, R33, R34, R35, R36, R37, R38, R39, R40, R41, R42, R43, R44, R45, R46, R47, R48, R49, R50, R52, R53, R54, R57, R58: 1k; R_Axial_DIN0207_L6.3mm_D2.5mm_P7.62mm_Horizontal
R51, R55: 10M; R_Axial_DIN0207_L6.3mm_D2.5mm_P7.62mm_Horizontal
R56: 1M; R_Axial_DIN0207_L6.3mm_D2.5mm_P7.62mm_Horizontal
RV1: 1M; Potentiometer_Bourns_PTV09A-1_Single_Vertical
SW1: SW_Push; SW_PUSH_6mm
U1, U3, U6, U8, U11, U12, U47, U52, U54: 74LS86; DIP-14_W7.62mm
U2, U4, U7, U9, U46, U53, U55: 74LS08; DIP-14_W7.62mm
U5, U10, U41, U42, U59: 74LS32; DIP-14_W7.62mm
U13, U14, U15, U16, U17, U18, U19, U20, U21, U22, U23, U24, U25, U26, U27, U28, U32, U33, U57, U58: 74LS157; DIP-16_W7.62mm
U29, U30, U31, U39, U43: 74LS377; DIP-20_W7.62mm
U34, U35: 74LS257; DIP-16_W7.62mm
U36, U60: 74LS245; DIP-20_W7.62mm
U37, U48, U49: 28C64; DIP-28_W15.24mm
U38: AS6C1008-55PCN; DIP-32_W15.24mm
U40: 74LS00; DIP-14_W7.62mm
U44, U45, U56: 74LS273; DIP-20_W7.62mm
U50, U51: NA555P; DIP-8_W7.62mm

Connections:
/Alu/Adder0/Bit1/Cin: U3.4, U4.4, U5.3
/Alu/Adder0/Bit2/Cin: U3.9, U4.9, U5.6
/Alu/Adder0/Bit3/Cin: U3.12, U4.12, U5.8
/Alu/Adder0/b0: U1.2, U2.2, U11.3
/Alu/Adder0/b1: U1.5, U2.5, U11.6
/Alu/Adder0/b2: U1.10, U2.10, U11.8
/Alu/Adder0/b3: U1.13, U2.13, U11.11
/Alu/Adder1/Bit1/Cin: U8.4, U9.4, U10.3
/Alu/Adder1/Bit2/Cin: U8.9, U9.9, U10.6
/Alu/Adder1/Bit3/Cin: U8.12, U9.12, U10.8
/Alu/Adder1/Cin: U5.11, U8.1, U9.1
/Alu/Adder1/b0: U6.2, U7.2, U12.3
/Alu/Adder1/b1: U6.5, U7.5, U12.6
/Alu/Adder1/b2: U6.10, U7.10, U12.8
/Alu/Adder1/b3: U6.13, U7.13, U12.11
/Alu/a0: U1.1, U2.1, U19.2, U20.13, U32.4
/Alu/a1: U1.4, U2.4, U19.5, U20.10, U32.7
/Alu/a2: U1.9, U2.9, U19.11, U20.6, U32.9
/Alu/a3: U1.12, U2.12, U19.14, U20.3, U32.12
/Alu/a4: U6.1, U7.1, U19.13, U20.2, U33.4
/Alu/a5: U6.4, U7.4, U19.10, U20.5, U33.7
/Alu/a6: U6.9, U7.9, U19.6, U20.11, U33.9
/Alu/a7: U6.12, U7.12, U19.3, U20.14, U33.12
/Alu/adderY0: U3.3, U13.2
/Alu/adderY1: U3.6, U13.5
/Alu/adderY2: U3.8, U13.11
/Alu/adderY3: U3.11, U13.14
/Alu/adderY4: U8.3, U14.2
/Alu/adderY5: U8.6, U14.5
/Alu/adderY6: U8.8, U14.11
/Alu/adderY7: U8.11, U14.14
/Alu/and0: U2.3, U5.1, U13.3
/Alu/and1: U2.6, U5.4, U13.6
/Alu/and2: U2.8, U5.9, U13.10
/Alu/and3: U2.11, U5.12, U13.13
/Alu/and4: U7.3, U10.1, U14.3
/Alu/and5: U7.6, U10.4, U14.6
/Alu/and6: U7.8, U10.9, U14.10
/Alu/and7: U7.11, U10.12, U14.13
/Alu/shifter/y0: U15.3, U27.4
/Alu/shifter/y1: U15.6, U27.7
/Alu/shifter/y2: U15.10, U27.9
/Alu/shifter/y3: U15.13, U27.12
/Alu/shifter/y4: U16.3, U28.4
/Alu/shifter/y5: U16.6, U28.7
/Alu/shifter/y6: U16.10, U28.9
/Alu/shifter/y7: U16.13, U28.12
/Alu/xor0: U1.3, U3.2, U4.2, U15.2
/Alu/xor1: U1.6, U3.5, U4.5, U15.5
/Alu/xor2: U1.8, U3.10, U4.10, U15.11
/Alu/xor3: U1.11, U3.13, U4.13, U15.14
/Alu/xor4: U6.3, U8.2, U9.2, U16.2
/Alu/xor5: U6.6, U8.5, U9.5, U16.5
/Alu/xor6: U6.8, U8.10, U9.10, U16.11
/Alu/xor7: U6.11, U8.13, U9.13, U16.14
/bus0: U11.1, U21.1, U22.1, U30.3, U31.3, U34.4, U36.18, U37.11, U38.13, U39.3, U43.3, U57.3, U60.18
/bus1: U11.4, U23.1, U24.1, U30.4, U31.4, U34.7, U36.17, U37.12, U38.14, U39.4, U43.4, U57.6, U60.17
/bus2: U11.9, U25.1, U26.1, U30.7, U31.7, U34.12, U36.16, U37.13, U38.15, U39.7, U43.7, U57.10, U60.16
/bus3: U11.12, U30.8, U31.8, U34.9, U36.15, U37.15, U38.17, U39.8, U43.8, U57.13, U60.15
/bus4: U12.1, U30.13, U31.13, U35.4, U36.14, U37.16, U38.18, U39.13, U43.13, U58.3, U60.14
/bus5: U12.4, U30.14, U31.14, U35.7, U36.13, U37.17, U38.19, U39.14, U43.14, U58.6, U60.13
/bus6: U12.9, U30.17, U31.17, U35.12, U36.12, U37.18, U38.20, U39.17, U43.17, U58.10, U60.12
/bus7: U12.12, U30.18, U31.18, U35.9, U36.11, U37.19, U38.21, U39.18, U43.18, U58.13, U60.11
/clock/clk0: R51.2, U51.3
/clock/clk1: R55.2, U50.3
/control/a0: U44.2, U46.1, U46.9, U47.2, U47.4, U48.10, U49.10
/control/a1: U44.5, U46.2, U47.5, U48.9, U49.9
/control/a2: U44.6, U47.9, U47.13, U48.8, U49.8
/control/a6: U45.9, U48.4, U49.4
/control/a7: U45.12, U48.3, U49.3
/control/a8: U45.15, U48.25, U49.25
/control/a9: U45.16, U48.24, U49.24
/control/a10: U45.19, U48.21, U49.21
/control/a11: U44.12, U48.23, U49.23
/control/a12: U44.9, U48.2, U49.2
/pc/pc0: U52.2, U52.4, U53.1, U56.2, U60.2
/pc/pc1: U52.5, U53.2, U56.5, U60.3
/pc/pc2: U52.10, U53.5, U56.6, U60.4
/pc/pc3: U52.13, U53.10, U56.9, U60.5
/pc/pc4: U53.13, U54.2, U56.12, U60.6
/pc/pc5: U54.5, U55.2, U56.15, U60.7
/pc/pc6: U54.10, U55.5, U56.16, U60.8
/pc/pc7: U54.13, U56.19, U60.9
/ram/ramNOE: U38.24, U40.8
/ram/ramNWE: U38.29, U40.3
/ram/romNOE: U37.22, U40.11
/regset/r00: R9.2, U30.2, U32.2, U34.2
/regset/r01: R10.2, U30.5, U32.5, U34.5
/regset/r02: R11.2, U30.6, U32.11, U34.14
/regset/r03: R12.2, U30.9, U32.14, U34.11
/regset/r04: R13.2, U30.12, U33.2, U35.2
/regset/r05: R14.2, U30.15, U33.5, U35.5
/regset/r06: R15.2, U30.16, U33.11, U35.14
/regset/r07: R16.2, U30.19, U33.14, U35.11
/regset/r10: R17.2, U31.2, U32.3, U34.3
/regset/r11: R18.2, U31.5, U32.6, U34.6
/regset/r12: R19.2, U31.6, U32.10, U34.13
/regset/r13: R20.2, U31.9, U32.13, U34.10
/regset/r14: R21.2, U31.12, U33.3, U35.3
/regset/r15: R22.2, U31.15, U33.6, U35.6
/regset/r16: R23.2, U31.16, U33.10, U35.13
/regset/r17: R24.2, U31.19, U33.13, U35.10
GND: C1.2, C2.2, C3.2, C5.1, D1.1, D2.1, D3.1, D4.1, D5.1, D6.1, D7.1, D8.1, D9.1, D10.1, D11.1, D12.1, D13.1, D14.1, D15.1, D16.1, D17.1, D18.1, D19.1, D20.1, D21.1, D22.1, D23.1, D24.1, D25.1, D26.1, D27.1, D28.1, D29.1, D30.1, D31.1, D32.1, D33.1, D34.1, D35.1, D36.1, D37.1, D38.1, D39.1, D40.1, D41.1, D42.1, D43.1, D44.1, D45.1, D46.1, D47.1, D48.1, D49.1, D50.1, D51.1, SW1.1, U1.7, U2.7, U3.7, U4.7, U5.7, U6.7, U7.7, U8.7, U9.7, U10.7, U11.7, U12.7, U13.8, U13.15, U14.8, U14.15, U15.8, U15.15, U16.8, U16.15, U17.8, U17.15, U18.8, U18.15, U19.8, U19.15, U20.8, U20.15, U21.8, U21.15, U22.8, U22.13, U22.15, U23.8, U23.15, U24.8, U24.10, U24.13, U24.15, U25.8, U25.15, U26.3, U26.6, U26.8, U26.10, U26.13, U26.15, U27.8, U27.15, U28.8, U28.15, U29.10, U30.10, U31.10, U32.8, U32.15, U33.8, U33.15, U34.8, U35.8, U36.10, U37.2, U37.14, U37.20, U37.21, U37.23, U37.24, U38.2, U38.3, U38.4, U38.16, U38.22, U38.23, U38.25, U38.26, U38.27, U38.28, U38.31, U39.10, U40.7, U41.7, U41.12, U41.13, U42.7, U43.10, U44.10, U44.14, U44.17, U44.18, U45.10, U46.7, U46.12, U46.13, U47.7, U48.14, U48.20, U48.22, U49.14, U49.20, U49.22, U50.1, U51.1, U52.7, U53.7, U54.7, U55.7, U55.12, U55.13, U56.10, U57.8, U57.15, U58.8, U58.15, U59.4, U59.5, U59.7, U59.9, U59.10, U59.12, U59.13, U60.10
unnamed: C1.1, U51.5
unnamed: C2.1, RV1.3, U51.2, U51.6
unnamed: C3.1, U50.5
unnamed: C4.1, R54.2, U50.2
unnamed: C4.2, R53.2, SW1.2
unnamed: C5.2, R56.2, U50.6, U50.7
unnamed: D1.2, R1.1
unnamed: D2.2, R2.1
unnamed: D3.2, R3.1
unnamed: D4.2, R4.1
unnamed: D5.2, R5.1
unnamed: D6.2, R6.1
unnamed: D7.2, R7.1
unnamed: D8.2, R8.1
unnamed: D9.2, R9.1
unnamed: D10.2, R10.1
unnamed: D11.2, R11.1
unnamed: D12.2, R12.1
unnamed: D13.2, R13.1
unnamed: D14.2, R14.1
unnamed: D15.2, R15.1
unnamed: D16.2, R16.1
unnamed: D17.2, R17.1
unnamed: D18.2, R18.1
unnamed: D19.2, R19.1
unnamed: D20.2, R20.1
unnamed: D21.2, R21.1
unnamed: D22.2, R22.1
unnamed: D23.2, R23.1
unnamed: D24.2, R24.1
unnamed: D25.2, R25.1
unnamed: D26.2, R26.1
unnamed: D27.2, R27.1
unnamed: D28.2, R28.1
unnamed: D29.2, R29.1
unnamed: D30.2, R30.1
unnamed: D31.2, R31.1
unnamed: D32.2, R32.1
unnamed: D33.2, R33.1
unnamed: D34.2, R34.1
unnamed: D35.2, R35.1
unnamed: D36.2, R36.1
unnamed: D37.2, R37.1
unnamed: D38.2, R38.1
unnamed: D39.2, R39.1
unnamed: D40.2, R40.1
unnamed: D41.2, R41.1
unnamed: D42.2, R42.1
unnamed: D43.2, R43.1
unnamed: D44.2, R44.1
unnamed: D45.2, R45.1
unnamed: D46.2, R46.1
unnamed: D47.2, R47.1
unnamed: D48.2, R48.1
unnamed: D49.2, R49.1
unnamed: D50.2, R50.1
unnamed: D51.2, R58.1
unnamed: R2.2, U29.16, U36.8, U41.10
unnamed: R3.2, U29.15, U36.7, U41.5
unnamed: R4.2, U29.12, U36.6, U41.2
unnamed: R5.2, U29.9, U36.5, U42.13
unnamed: R6.2, U29.6, U36.4, U42.10
unnamed: R7.2, U29.5, U36.3, U42.5
unnamed: R8.2, U29.2, U36.2, U42.2
unnamed: R25.2, U37.3, U38.5, U39.19
unnamed: R26.2, U37.4, U38.6, U39.16
unnamed: R27.2, U37.5, U38.7, U39.15
unnamed: R28.2, U37.6, U38.8, U39.12
unnamed: R29.2, U37.7, U38.9, U39.9
unnamed: R30.2, U37.8, U38.10, U39.6
unnamed: R31.2, U37.9, U38.11, U39.5
unnamed: R32.2, U37.10, U38.12, U39.2
unnamed: R52.1, R57.2, U51.7
unnamed: R52.2, RV1.2
unnamed: U4.3, U5.2
unnamed: U4.6, U5.5
unnamed: U4.8, U5.10
unnamed: U4.11, U5.13
unnamed: U9.3, U10.2
unnamed: U9.6, U10.5
unnamed: U9.8, U10.10
unnamed: U9.11, U10.13
unnamed: U13.4, U17.2
unnamed: U13.7, U17.5
unnamed: U13.9, U17.11
unnamed: U13.12, U17.14
unnamed: U14.4, U18.2
unnamed: U14.7, U18.5
unnamed: U14.9, U18.11
unnamed: U14.12, U18.14
unnamed: U15.4, U17.3
unnamed: U15.7, U17.6
unnamed: U15.9, U17.10
unnamed: U15.12, U17.13
unnamed: U16.4, U18.3
unnamed: U16.7, U18.6
unnamed: U16.9, U18.10
unnamed: U16.12, U18.13
unnamed: U17.4, U29.3
unnamed: U17.7, U29.4
unnamed: U17.9, U29.7
unnamed: U17.12, U29.8
unnamed: U18.4, U29.13
unnamed: U18.7, U29.14
unnamed: U18.9, U29.17
unnamed: U18.12, U29.18
unnamed: U19.4, U21.2
unnamed: U19.7, U21.3, U21.5
unnamed: U19.9, U21.6, U21.11
unnamed: U19.12, U21.10, U21.14
unnamed: U20.4, U21.13, U22.2
unnamed: U20.7, U22.3, U22.5
unnamed: U20.9, U22.6, U22.11
unnamed: U20.12, U22.10, U22.14
unnamed: U21.4, U23.2
unnamed: U21.7, U23.5
unnamed: U21.9, U23.3, U23.11
unnamed: U21.12, U23.6, U23.14
unnamed: U22.4, U23.10, U24.2
unnamed: U22.7, U23.13, U24.5
unnamed: U22.9, U24.3, U24.11
unnamed: U22.12, U24.6, U24.14
unnamed: U23.4, U25.2
unnamed: U23.7, U25.5
unnamed: U23.9, U25.11
unnamed: U23.12, U25.14
unnamed: U24.4, U25.3, U26.2
unnamed: U24.7, U25.6, U26.5
unnamed: U24.9, U25.10, U26.11
unnamed: U24.12, U25.13, U26.14
unnamed: U25.4, U27.2, U28.13
unnamed: U25.7, U27.5, U28.10
unnamed: U25.9, U27.11, U28.6
unnamed: U25.12, U27.14, U28.3
unnamed: U26.4, U27.13, U28.2
unnamed: U26.7, U27.10, U28.5
unnamed: U26.9, U27.6, U28.11
unnamed: U26.12, U27.3, U28.14
unnamed: U40.6, U40.9
unnamed: U41.1, U41.6
unnamed: U41.3, U42.12
unnamed: U41.4, U41.8
unnamed: U42.1, U42.6
unnamed: U42.4, U42.8
unnamed: U42.9, U42.11
unnamed: U43.2, U45.3
unnamed: U43.5, U45.4
unnamed: U43.6, U45.7
unnamed: U43.9, U45.8
unnamed: U43.12, U45.13
unnamed: U43.15, U45.14
unnamed: U43.16, U45.17
unnamed: U43.19, U45.18
unnamed: U44.3, U47.3
unnamed: U44.4, U46.10, U47.6
unnamed: U44.7, U47.8
unnamed: U46.3, U47.10
unnamed: U46.4, U47.11
unnamed: U46.5, U46.8
unnamed: U52.3, U57.2
unnamed: U52.6, U57.5
unnamed: U52.8, U57.11
unnamed: U52.9, U53.3, U53.4
unnamed: U52.11, U57.14
unnamed: U52.12, U53.6, U53.9
unnamed: U53.11, U54.4, U55.1
unnamed: U53.8, U53.12, U54.1
unnamed: U54.3, U58.2
unnamed: U54.6, U58.5
unnamed: U54.8, U58.11
unnamed: U54.9, U55.3, U55.4
unnamed: U54.11, U58.14
unnamed: U54.12, U55.6
unnamed: U55.8, U56.11
unnamed: U55.10, U59.3
unnamed: U56.3, U57.4
unnamed: U56.4, U57.7
unnamed: U56.7, U57.9
unnamed: U56.8, U57.12
unnamed: U56.13, U58.4
unnamed: U56.14, U58.7
unnamed: U56.17, U58.9
unnamed: U56.18, U58.12
clk: R51.1, R53.1, R54.1, R55.1, R56.1, R57.1, U1.14, U2.14, U3.14, U4.14, U5.14, U6.14, U7.14, U8.14, U9.14, U10.14, U11.14, U12.14, U13.16, U14.16, U15.16, U16.16, U17.16, U18.16, U19.16, U20.16, U21.16, U22.16, U23.16, U24.16, U25.16, U26.16, U27.16, U28.16, U29.11, U29.20, U30.11, U30.20, U31.11, U31.20, U32.16, U33.16, U34.16, U35.16, U36.1, U36.20, U37.27, U37.28, U38.30, U38.32, U39.11, U39.20, U40.2, U40.14, U41.14, U42.14, U43.11, U43.20, U44.1, U44.11, U44.20, U45.1, U45.11, U45.20, U46.14, U47.1, U47.12, U47.14, U48.27, U48.28, U49.27, U49.28, U50.4, U50.8, U51.4, U51.8, U52.1, U52.14, U53.14, U54.14, U55.9, U55.14, U56.1, U56.20, U57.16, U58.16, U59.14, U60.1, U60.20
ctrlAluNOE: R35.2, U36.19, U48.11
ctrlAluOp0: U17.1, U18.1, U45.5, U48.6, U49.6
ctrlAluOp1: U13.1, U14.1, U15.1, U16.1, U45.6, U48.5, U49.5
ctrlAluSel: R41.2, U32.1, U33.1, U48.18
ctrlAluSub: U3.1, U4.1, U11.2, U11.5, U11.10, U11.13, U12.2, U12.5, U12.10, U12.13, U19.1, U20.1, U27.1, U28.1, U45.2, U48.7, U49.7
ctrlAluYNWE: R36.2, U29.1, U48.12
ctrlInstrNWE: R33.2, R34.2, R58.2, U37.25, U43.1, U46.6, U57.1, U58.1, U59.2
ctrlMarNWE: R42.2, U39.1, U48.19
ctrlPCLoad: R45.2, U49.13, U59.1
ctrlPCNOE: R48.2, U49.17, U60.19
ctrlRamOE: R44.2, U40.10, U40.12, U49.12
ctrlRamSelect: R46.2, U40.4, U40.5, U40.13, U49.15
ctrlRamWE: R43.2, U40.1, U49.11
ctrlReg0NWE: R37.2, U30.1, U48.13
ctrlReg1NWE: R38.2, U31.1, U48.15
ctrlRegBusNOE: R40.2, U34.15, U35.15, U48.17
ctrlRegBusSel: R39.2, U34.1, U35.1, U48.16
flagNZero: U42.3, U44.8
flagNegative: R1.2, U29.19, U36.9, U41.9, U44.13
