Nik-Sch/EDiC/vivado/MEDiC.runs/control_bd_instrRom_0_synth_1/control_bd_instrRom_0_stub.v

// Copyright 1986-2021 Xilinx, Inc. All Rights Reserved.
// --------------------------------------------------------------------------------
// Tool Version: Vivado v.2021.1 (lin64) Build 3247384 Thu Jun 10 19:36:07 MDT 2021
// Date        : Fri Sep 24 23:37:47 2021
// Host        : niklasPC running 64-bit Manjaro Linux
// Command     : write_verilog -force -mode synth_stub -rename_top decalper_eb_ot_sdeen_pot_pi_dehcac_xnilix -prefix
//               decalper_eb_ot_sdeen_pot_pi_dehcac_xnilix_ control_bd_instrRom_0_stub.v
// Design      : control_bd_instrRom_0
// Purpose     : Stub declaration of top-level module interface
// Device      : xc7a100tcsg324-3
// --------------------------------------------------------------------------------

// This empty module with port declaration file causes synthesis tools to infer a black box for IP.
// The synthesis directives are for Synopsys Synplify support to prevent IO buffer insertion.
// Please paste the declaration into a Verilog source file or add the file as an additional source.
(* x_core_info = "blk_mem_gen_v8_4_4,Vivado 2021.1" *)
module decalper_eb_ot_sdeen_pot_pi_dehcac_xnilix(clka, ena, addra, douta)
/* synthesis syn_black_box black_box_pad_pin="clka,ena,addra[14:0],douta[23:0]" */;
  input clka;
  input ena;
  input [14:0]addra;
  output [23:0]douta;
endmodule
