Nik-Sch/EDiC/sim_ttl/_src/ic74LS273.v

// octal register with clear https://www.ti.com/lit/ds/symlink/sn74ls273.pdf
module ic74LS273(
input wire port1,
output reg port2,
input wire port3,
input wire port4,
output reg port5,
output reg port6,
input wire port7,
input wire port8,
output reg port9,
input wire port10,
input wire port11,
output reg port12,
input wire port13,
input wire port14,
output reg port15,
output reg port16,
input wire port17,
input wire port18,
output reg port19,
input wire port20
);

always @(posedge port11, negedge port1) begin

  port2 <= port3;
  port5 <= port4;
  port6 <= port7;
  port9 <= port8;
  port12 <= port13;
  port15 <= port14;
  port19 <= port18;
  port16 <= port17;

  if (~port1) begin
    port2 <= 0;
    port5 <= 0;
    port6 <= 0;
    port9 <= 0;
    port12 <= 0;
    port15 <= 0;
    port19 <= 0;
    port16 <= 0;

  end
end

endmodule
