Nik-Sch/EDiC/(commit log)

2020-11-15 it does stuff and executed 2 instructions 🎉
2020-11-18 added kicad schematics and ram instructions
2020-11-20 added arduino nano 8bit to 7seg decoder
2020-12-13 zero flag got nonZero and added current image
2020-12-25 Added schematic
2021-01-20 starting kicad version
    [1BitFullAdder.sch, 4BitFullAdder.sch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]
2021-01-23 pcbVersion: kicad alu design
    [1BitFullAdder.sch, 4BitFullAdder.sch, Alu.sch, PCBVersion.kicad_pcb, PCBVersion.sch, Shifter.sch]
2021-01-24 pcbVersion: regset + alu
    [1BitFullAdder.sch, 4BitFullAdder.sch, Alu.sch, PCBVersion.sch, Regset.sch, Shifter.sch]
2021-01-28 pcbversion: ram, started pc
    [1BitFullAdder.sch, 4BitFullAdder.sch, Alu.sch, Clock.sch, Control.sch, PC.sch, PCBVersion.kicad_pcb, PCBVersion.sch]
2021-01-30 pcbVersion: kinda done
    [Clock.sch, Control.sch, PC.sch, PCBVersion.kicad_pcb, PCBVersion.sch]
2021-07-31 schematic finished
    [8bitCPU.sch, Alu.sch, Control.sch, PC.sch, Ram.sch, Regset.sch, Shifter.sch, io.sch]
2021-07-31 schematic zip
2021-08-02 updated schematic
    [8bitCPU.sch, PC.sch]
2021-09-23 pre upgrade to vivado 2021
    [1BitFullAdder.sch, 4BitFullAdder.sch, 8bitCPU.sch, Alu.sch, Clock.sch, Control.sch, Memory.sch, PC.sch]
2021-09-24 fibonacci works again with new memory design
    [1BitFullAdder.sch, 4BitFullAdder.sch, 8bitCPU.sch, Alu.sch, Clock.sch, Control.sch, Memory.sch, Regset.sch]
2021-09-25 schematic with henry
    [1BitFullAdder.sch, 4BitFullAdder.sch, 8bitCPU.csv, 8bitCPU.sch, Alu.sch, Clock.sch, Control.sch, Memory.sch]
2021-10-01 updated verilog from schematic
    [1BitFullAdder.sch, 4BitFullAdder.sch, Alu.sch, Memory.sch, io.sch]
2021-10-25 updated some more verilog
    [Alu.sch, Control.sch]
2021-10-25 renamed project
    [8bitCPU.sch, Alu.sch, Clock.sch, Control.sch, MEDiC.csv, MEDiC.kicad_pcb, MEDiC.sch, Memory.sch]
2021-10-25 fibonacci works again, sp etc needs to be tested
    [Control.sch, Memory.sch]
2021-10-31 fixed a lot of smaller bugs, function call and return works now
    factorization and fibonacci implemented
    [generateMicroCode.py]
2021-11-14 asm: added constants tb: simulate with 100MHz/5MHz clocks as in synth + increment switches now and then
2021-11-19 works on the fpga 🎉
2021-11-21 debugged debugging
    [Control.sch, Memory.sch]
2021-11-22 prng + snake in python + bug carry fix in alu
    [alu.v]
2021-11-26 added uart expansion card
2021-11-27 snaky snake started and some bugs fixed
    [control_bd_instrRom_0_stub.v]
2021-11-28 schematic: alu/shifter carry fix
    [Alu.sch, Shifter.sch]
2021-11-29 fixed uart_rx and snake
    [Alu.sch, Control.sch, Memory.sch, Shifter.sch]
2021-11-30 started with schematic poster
    [1BitFullAdder.sch, 4BitFullAdder.sch, Alu.sch, Clock.sch, Control.sch, EDiCPoster.kicad_pcb, EDiCPoster.sch, Memory.sch]
2021-12-01 reposition in poster
    [EDiCPoster.sch]
2021-12-01 kicad 6
    [EDiCPoster.kicad_sch]
2021-12-03 poster passed erc, check
    [EDiCPoster.kicad_sch]
2021-12-03 started anotating poster
    [EDiCPoster.kicad_sch]
2021-12-06 restructured folders
    [EDiCPoster.kicad_sch, Memory.sch, io.sch]
2021-12-11 netlist2verilog converter started
    [1BitFullAdder.kicad_sch, 4BitFullAdder.kicad_sch, Alu.kicad_sch, Clock.kicad_sch, Control.kicad_sch, EDiC.kicad_sch, EDiCPoster.kicad_sch, Memory.kicad_sch]
2021-12-13 netlist simulation works
    [Alu.kicad_sch, EDiC.kicad_sch, io.kicad_sch]
2021-12-22 ttl fpga: factorization works in sim and fpga
    [1BitFullAdder.kicad_sch, 4BitFullAdder.kicad_sch, Alu.kicad_sch, Clock.kicad_sch, Control.kicad_sch, EDiC.kicad_sch, Memory.kicad_sch, Regset.kicad_sch]
2021-12-26 io: async register + reversed bus
    [1BitFullAdder.kicad_sch, 4BitFullAdder.kicad_sch, EDiC.kicad_sch, io.kicad_sch]
2021-12-28 carry flag + ram critical path
    [4BitFullAdder.kicad_sch, Alu.kicad_sch]
2022-01-10 snake debugging, fixed bug in the netlist
    [expansion_uart.v, testbench.sv, tristatenet.v]
2022-01-19 singal testing board top
2022-01-26 uart 16c550.s
2022-01-29 snake works with uart io card
    include directive for assembler
2022-03-07 Inbetriebnahme Day 2
    [RigolDS0.csv]
2022-03-08 fix for buggy uart chip
2022-04-22 alu figures, modules finished
    [1BitFullAdder.kicad_sch, 4BitFullAdder.kicad_sch, Alu.kicad_sch, Clock.kicad_sch, Control.kicad_sch, Memory.kicad_sch, io.kicad_sch]
2022-05-23 assembler continued
2022-07-04 typos + schematics
2022-07-07 magnetic field, ee-stuff
2022-07-11 image of pcbs
2022-10-23 Vhdl conversion (#1)
    * starting conversion to vhdl
    * fpga kind of working again, pc stays at 0, however
    * fixed problems in 74x867
    snake works again
    [board_top.vhd, displayDriver.vhd, ic28C256.vhd, ic5082_7340.vhd, ic74x04.vhd]
